NTNU-IES-education/teknobil/README.md

# Teknostart - elektronisk systemdesign og innovasjon

Velkommen til Elsys! For å varme dere opp til studiene har vi laget et lite intro-prosjekt til dere. Under prosjektet skal dere bygge og kjøre deres egen fjernstyrte bil. Underveis får dere prøve dere på Raspberry Pi og Arduino. Kanskje dette er kjent for noen av dere, og helt nytt for andre. Det er helt greit. Vi forventer bare at dere er nysgjerrig og gira for å komme i gang:) Lykke til!

Det vanker også premie for den vakreste/kuleste bilen, så bruk kreativiteten, maling og tusjer til å skreddersy bilen slik dere ønsker.

Del dere opp og jobb parallelt på de ulike delene. Dere har god tid, så bruk den gjerne på å utforske og prøve dere fram. Vi foreslår at dere fordeler dere på disse hovedoppgavene:

1.	[Raspberry Pi](#sette-opp-sd-kortet): Her er det viktig å holde tungen rett i munnen og følge instruksjonene nøye.  
2.	[Arduino](#Arduino)
3.  Steg 1 - 5

Til slutt kan dere samarbeide om å koble alt sammen og få bilen til å fungere. Når bilen fungerer kan dere gå videre med utvidelsesoppgavene og/eller skreddersy estetikken slik dere ønsker.

Står dere fast? Spør studassene om hjelp! Vi er her for å hjelpe dere, og kanskje føle oss litt smarte underveis:)

## Innholdsfortegnelse
- [Introduksjon til komponentene](#introduksjon-til-komponentene)
- [Trinnvisveiledning for montering av Teknobilen](#Trinnvis-veiledning-for-montering-av-Teknobilen)
  - [Montering av Teknobilen](#Montering-av-Teknobilen)
  - [Arduino](#arduino)
  - [Raspberry Pi Oppsett](#raspberry-pi-oppsett)
- [Utvidelser](#utvidelser)
  - [Hastighet](#hastighet)
  - [led](#led)
  - [Tutehorn](#tutehorn)
  - [Lobe](#lobe)
****

# Introduksjon til komponentene

Settet dere har fått utdelt inneholder komponenter som sikkert er nye for mange av dere. Her er en liten gjennomgang som forklarer hva de gjør. Det er ikke nødvendig å lese denne delen så nøye, men dere kan se over for å forstå hvilke komponenter vi omtaler i instruksjonene.

## Breadboard

Et breadboard gir en rask måte å koble opp kretser for prototyping uten å måtte lodde eller lage kabler. Hver rad i breadboardet er koblet til samme spenning.

<p align="center">
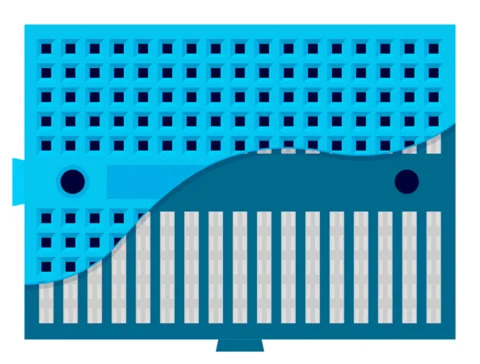
[picture p1: Media/teknobil/Breadboard.jpg]
  
</p>

## Spenningsregulator

Komponenten på bildet under er en spenningsregulator. Denne er viktig fordi Arduino og Raspberry Pi tåler ikke høyere spenning enn 5 V, men batterispenningen er på over 7.2 V. Denne har da til formål å senke spenningen slik at både Arduino og Raspberry Pi kan drives fra samme kilde. [Her](https://wiki.dfrobot.com/Power_Module__SKU_DFR0205_) er lenke til dokumentasjon.

<p align="center">
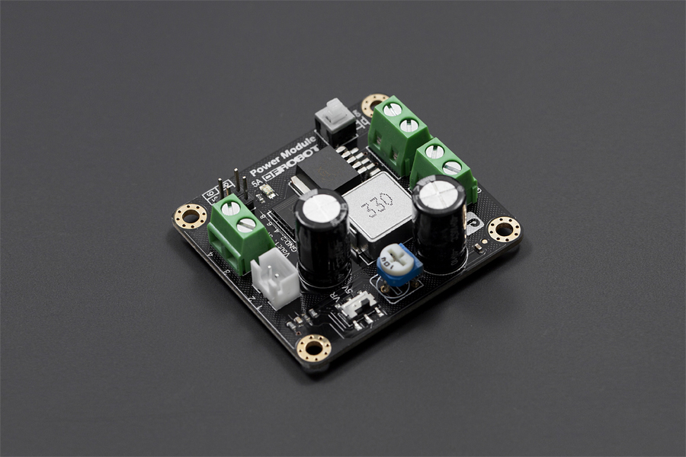
[picture p2: Media/teknobil/Powermodule.jpg]
  
</p>

## Arduino Uno

Arduino Uno er et lite utviklingskort som egner seg godt for nybegynnere. For å programmere denne brukes Arduino IDE med språket C++, supplert av Arduinos egne biblioteker og funksjoner. [Her](https://store.arduino.cc/pages/uno-r4) finner dere mer spesifikasjoner om kortet dere har blitt utdelt.

<p align="center">
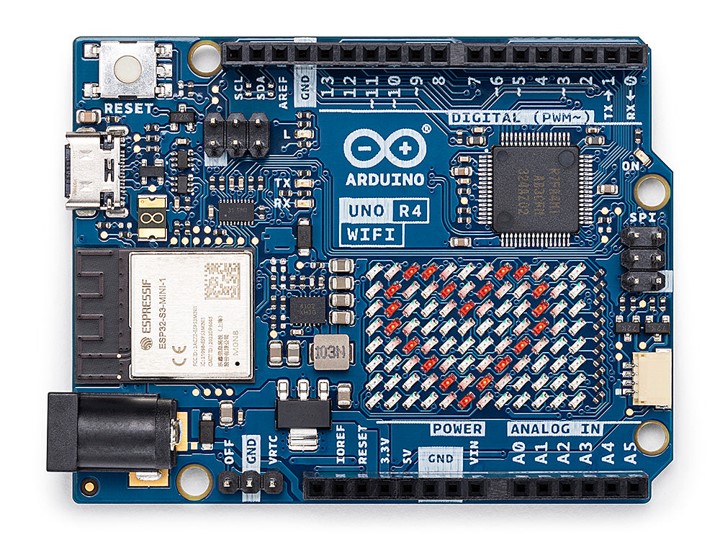
[picture p3: Media/teknobil/ArduinoUno.jpg]
  
</p>

## Motordriver

Motordriveren som dere har fått utdelt er et såkalt shield for Arduino Uno. Den kan plasseres rett på Arduino Uno, uten noen ekstra ledninger mellom de to. Denne må i tillegg kobles til motorspenning og til motorene den skal kontrollere. [Her](https://wiki.dfrobot.com/Quad_Motor_Driver_Shield_for_Arduino_SKU_DRI0039) finner dere ekstra dokumentasjon.

<p align="center">
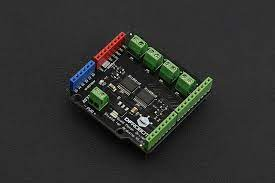
[picture p4: Media/teknobil/Motordriver.jpg]
  
</p>

## Raspberry Pi

Raspberry Pi er en liten datamaskin på størrelse med et kredittkort. Den klarer alt som forventes av en PC fra websurfing til dataspill. **PS! Det er low supply. Don't destroy plis😭** I dette prosjektet brukes modellen Raspberry Pi 3 Model B+. [Her](https://www.raspberrypi.com/documentation/) finner dere mer dokumentasjon om Raspberry Pi.

<p align="center">
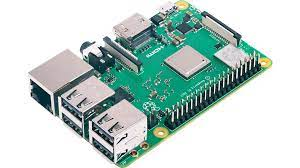
[picture p5: Media/teknobil/RaspberryPi3.jpg]
  
</p>

# Trinnvis veiledning for montering av Teknobilen
Før dere starter monteringen, er det greit å ha en oversikt over hvordan Teknobilen fungerer.

Raspberry Pi er systemets hjerne og kjører en nettside som lar dere styre bilen. Arduino tar seg av motorstyringen. De to kortene kommuniserer via GPIO-pinner, der Raspberry Pi sender kommandoer som Arduino bruker til å kontrollere motorene.

La oss montere! 

## Montering av Teknobilen

Følg trinnene nedenfor nøye for å montere Teknobilen. Alle bilder nevnt i veiledningen kan finnes i mappen [Media/teknobil](https://github.com/PeterhdPham/teknobil2023/tree/main/Media/teknobil).

### Steg 1: Montering av motorer

Start med å feste motorene til følgende plater med de 25 mm lange M3 skruene. Ledningene på motorene skal tres gjennom de store firkantede hullene. 
(NB! Ettersom dere ikke benytter muttere vær oppmerksom på ikke å stramme skruene for hardt).

<p align="center">
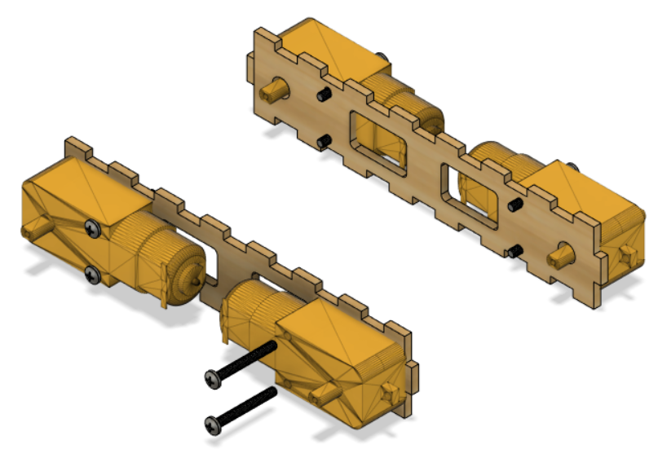
[picture p6: Media/teknobil/01.png]
  
</p>

### Steg 2: Sammensetting av baseplate og avlange plater

Fest så de avlange platene sammen med baseplaten (den store med hull). Pass på at baseplaten er riktig vei som vist på bildet slik at hullene passer med komponentene som skal skrus på senere.

<p align="center">
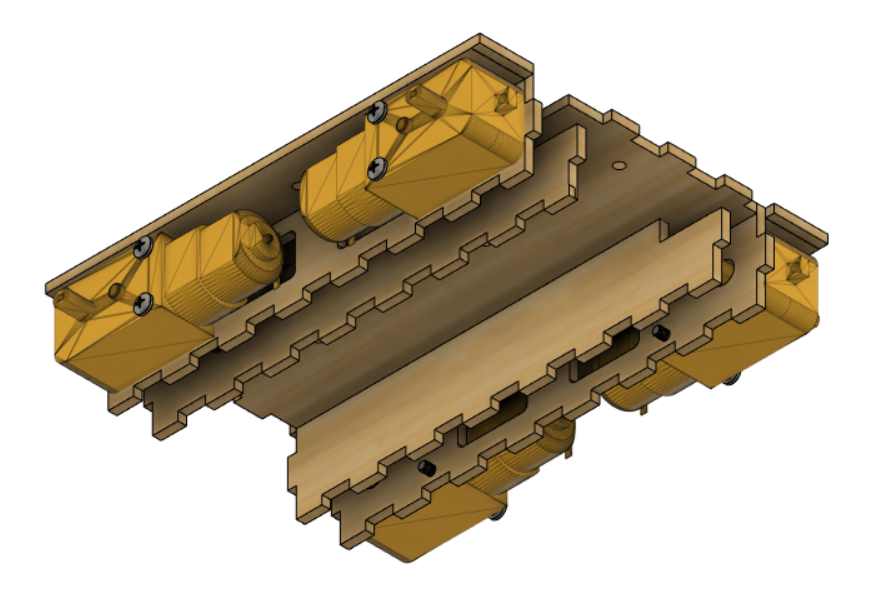
[picture p7: Media/teknobil/02.png]
  
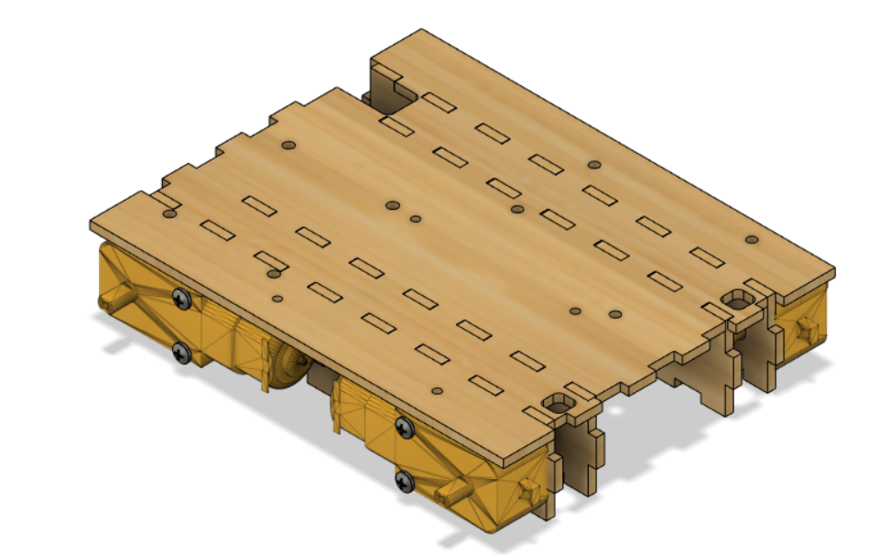
[picture p8: Media/teknobil/03.png]
  
</p>

### Steg 3: Ledninger

Nå kan det være lurt å føre ledningene fra motorene igjennom de to firkantede hullene i baseplaten.

<p align="center">
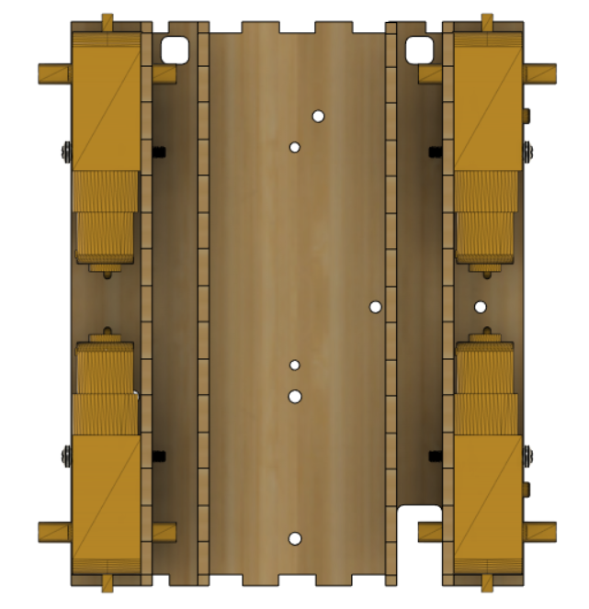
[picture p9: Media/teknobil/04.png]
  
</p>

### Steg 4: Montering av bunnplate

Fest bunnplaten.

<p align="center">
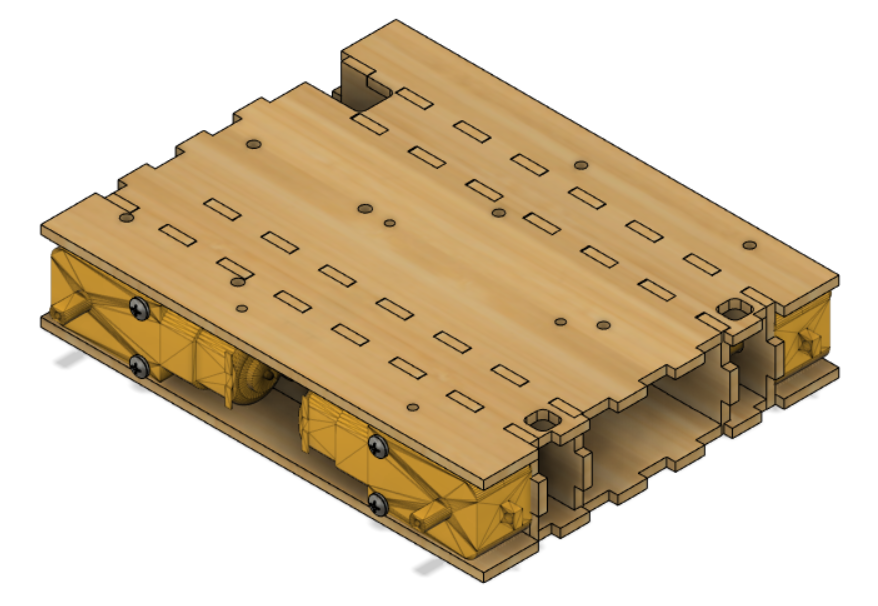
[picture p10: Media/teknobil/06.png]
  
</p>

### Steg 5: Raspbian

Før dere fortsetter med å feste komponentene bør oppsettet av Raspberry Pi være ferdig, ettersom dere ikke vil få tilgang til SD-kortet etter at alt er skrudd på plass. Dere bør ha fullført dette steget [her](#sette-opp-sd-kortet).

### Steg 6: Montering av komponenter

Legg komponentene som vist på bildet og skru dem fast inn i baseplaten med de 10 mm lange M2.5 skruene.

<p align="center">
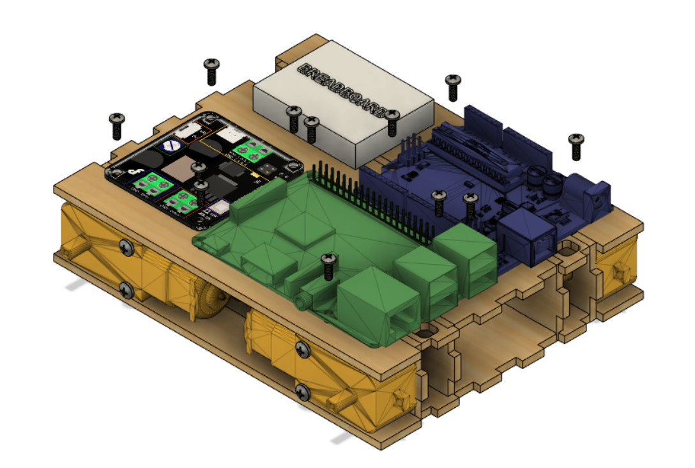
[picture p11: Media/teknobil/08.png]
  
</p>

### Steg 7: Montering av frontplate og kamera

Fest frontplaten og skru fast kameraet til platen med de 4 mm lange M2 skruene som vist på bildet under.

<p align="center">
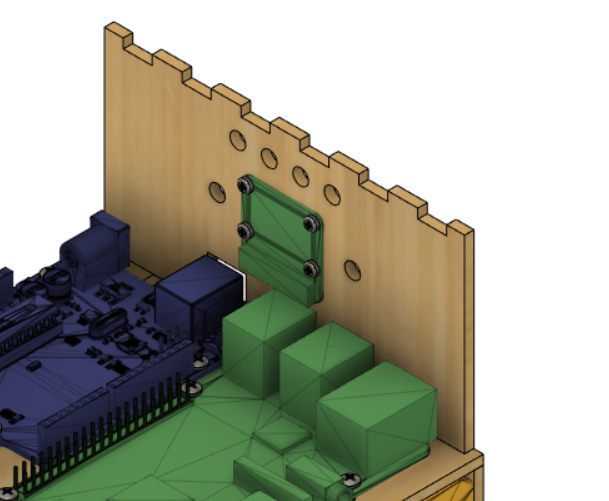
[picture p12: Media/teknobil/09.png]
  
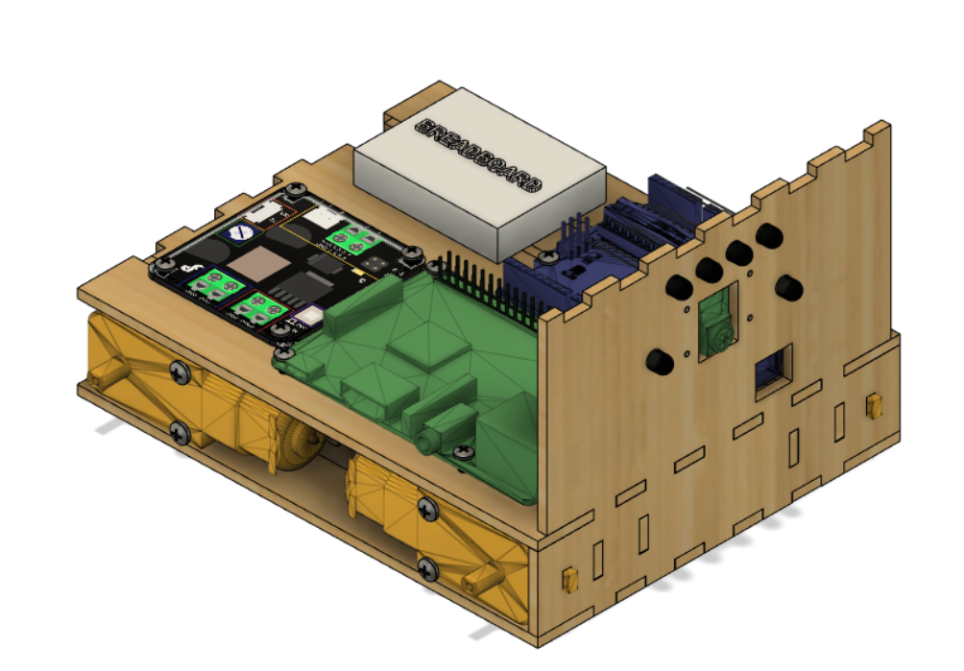
[picture p13: Media/teknobil/10.png]
  
</p>

Koble kamera til Raspberry Pi med den flate kamerakabelen som vist på bildet under. Sørg for å sette den inn riktig vei.

<p align="center">
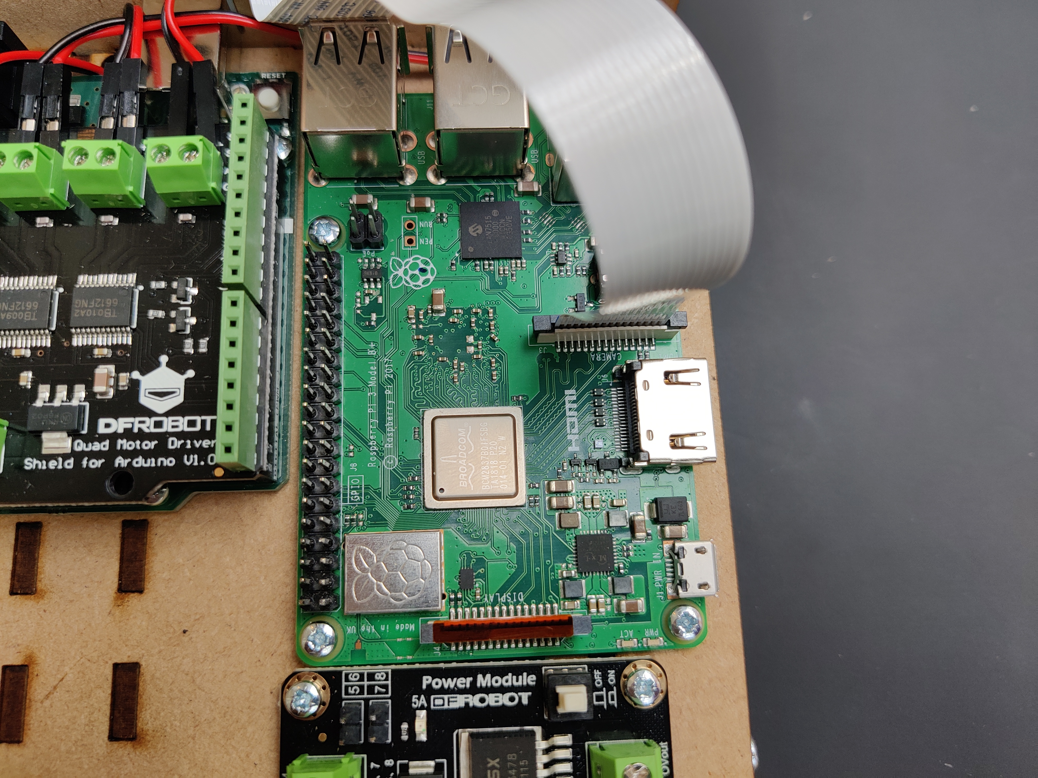
[picture p14: Media/teknobil/15.jpg]
  
</p>

### Steg 8: Oppkobling av spenningskilde og motor

Dere har nå kommet til et kritisk punkt i prosjektet - det er tid for å koble sammen komponentene. Det er avgjørende at dere følger koblingsskjemaene nøye. Ta en god titt på figurene og sørg for at dere har koblet riktig pins mellom spenningsregulatoren og Raspberry Pi samt Arduino.

Under ser dere pinout for Arduino, strømmodulen og Raspberry Pi.

Husk, nøyaktighet er nøkkelen her, så vær tålmodig og dobbeltsjekk alle tilkoblinger før dere fortsetter. I Illustrasjonen under så kobles 

<p align="center">
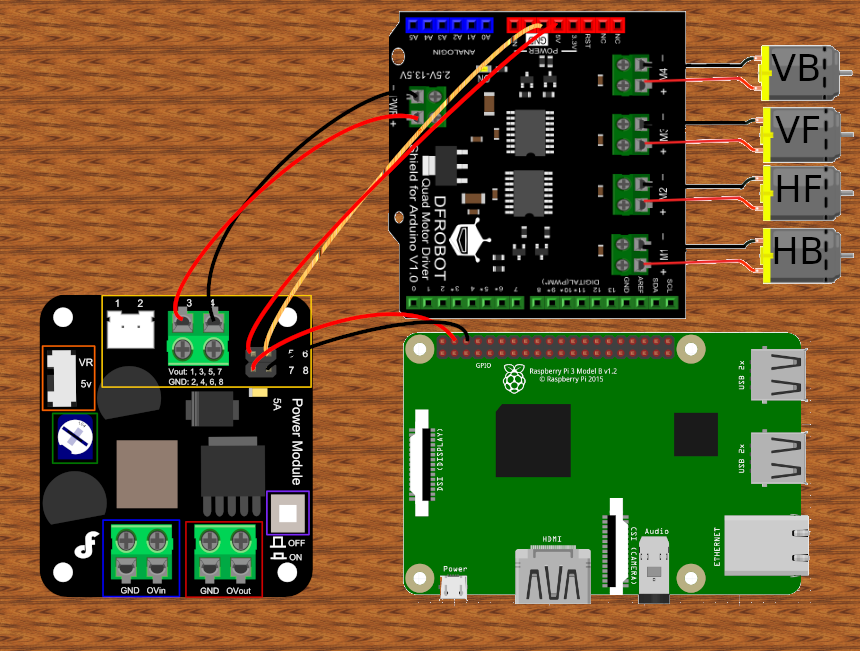
[picture p15: Media/teknobil/oppkoblingPSU.png]
  
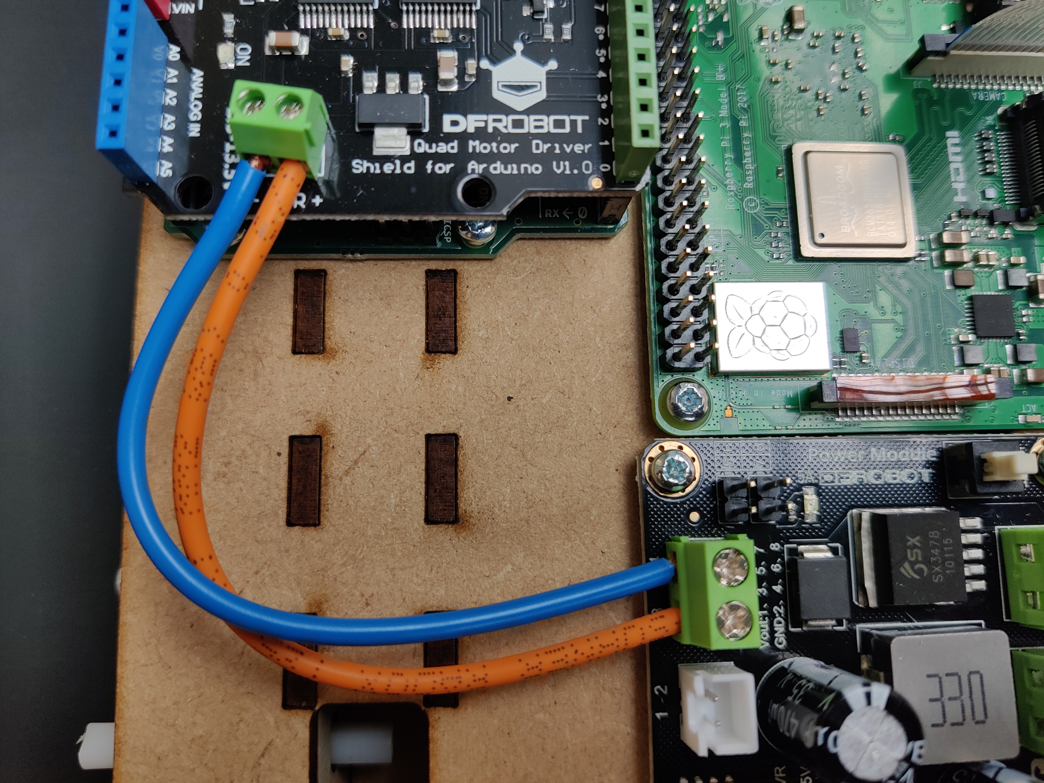
[picture p16: Media/teknobil/16.jpg]
  
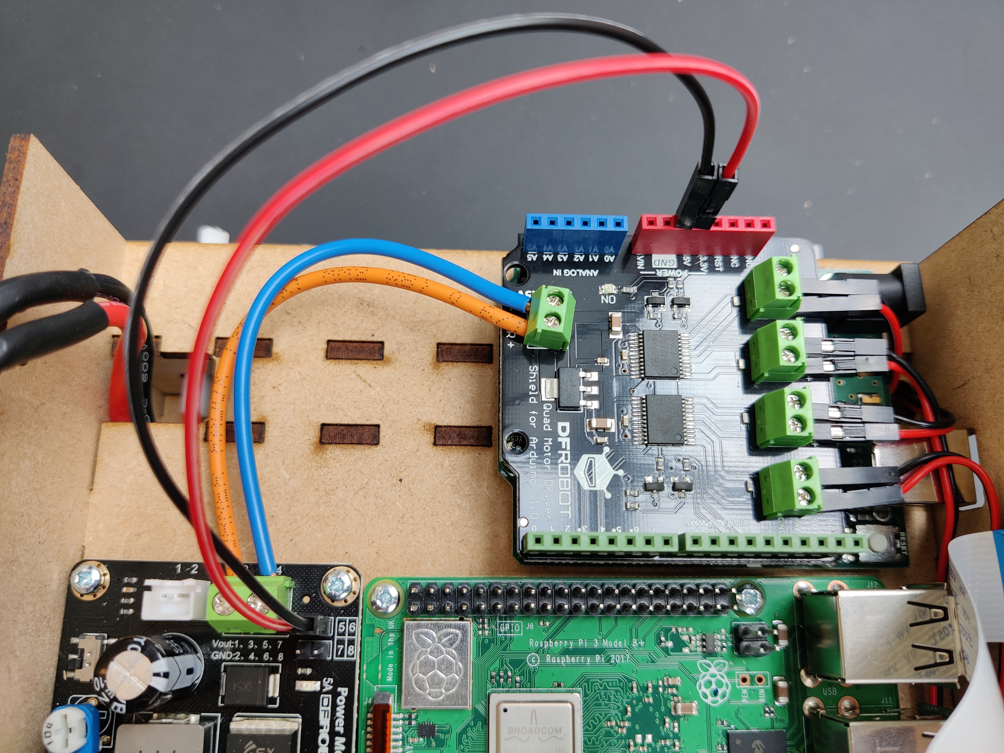
[picture p17: Media/teknobil/17.jpg]
  
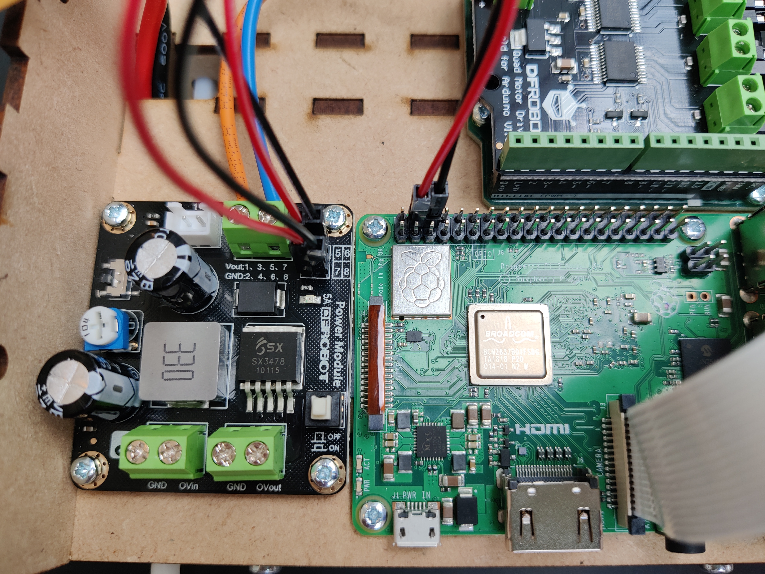
[picture p18: Media/teknobil/18.jpg]
  
</p>

som vist i illustrasjonen så kobles motorene og komponentene  slikt:

<table>
<tr><td>

| Motorshield | Motor |
|---|---|
| M1 | HØYRE BAK |
| M2 | HØYRE FRONT  |
| M3 | VENSTRE FRONT|
| M4 | VENSTRE BAK  |

</td><td>&nbsp;&nbsp;&nbsp;&nbsp;&nbsp;</td><td>

| Power Module | Arduino/RPI/Motor |
|---|--- |
| 3 (V_out) | Motor (+) |
| 4 (GND) | Motor (-) |
| 5 (V_out) | Arduino (5V) |
| 6 (GND) | Arduino (GND) |
| 7 (V_out) | RPI (5V PWR) |
| 8 (GND) | RPI (GND) |

</td></tr> </table>

### Steg 9: Oppkobling av GPIO

For å koble sammen Raspberry Pi og Arduino Uno, må dere merke deg at nummeret på GPIO-pinnen ikke er det samme som nummeret langs pinneraden på kortet som beskriver hvor pinnen er plassert. GPIO pinout for Raspberry Pi og tabell for tilkobling med Arduino er vist under. Bruk dette for å koble sammen de to kortene.

<p align="center">
  
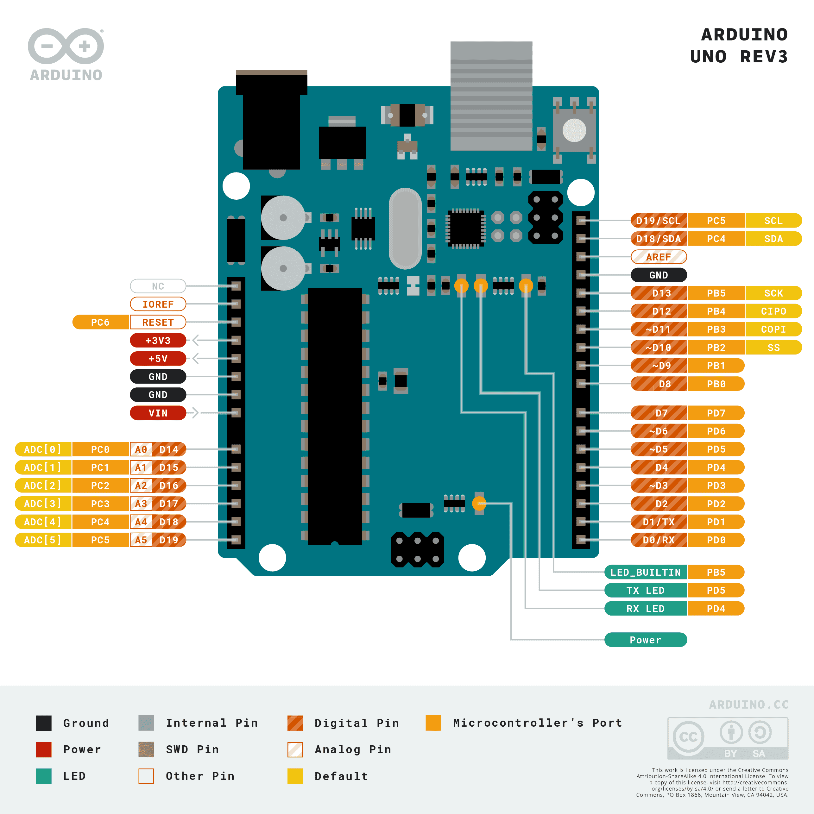
[picture p20: Media/teknobil/Arduino_pinout.png]
  
<table>
    <tr>
        <td>
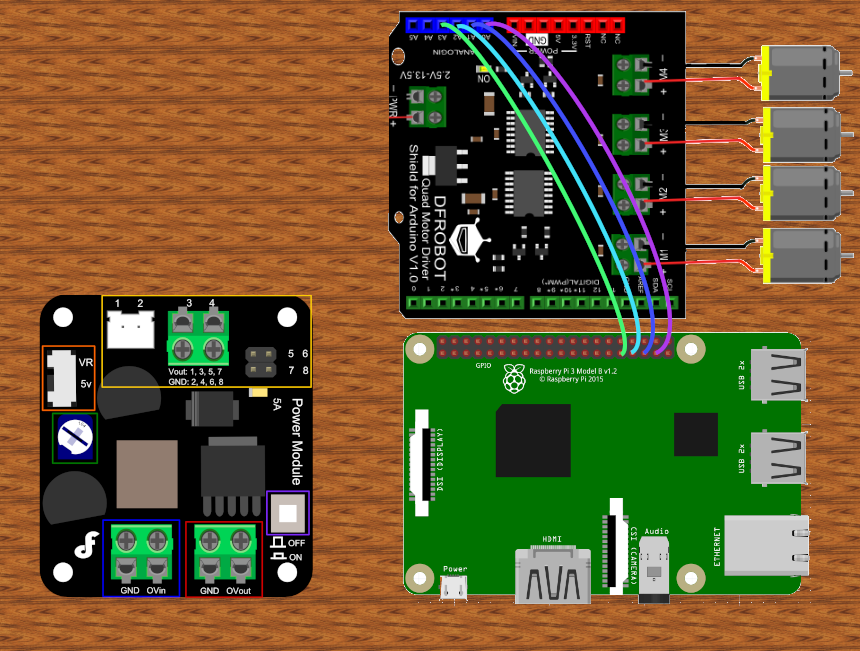
[picture p21: Media/teknobil/oppkoblingRPIArduino.png]
            
        </td>
        <td>
          
| Arduino | Raspberry Pi |
|---|---|
| A3 | GPIO 6 |
| A2 | GPIO 13 |
| A1 | GPIO 19 |
| A0 | GPIO 26 |

</table>

Hvis dere har koblet riktig, skal det se ut som vist under.

<p align="center">
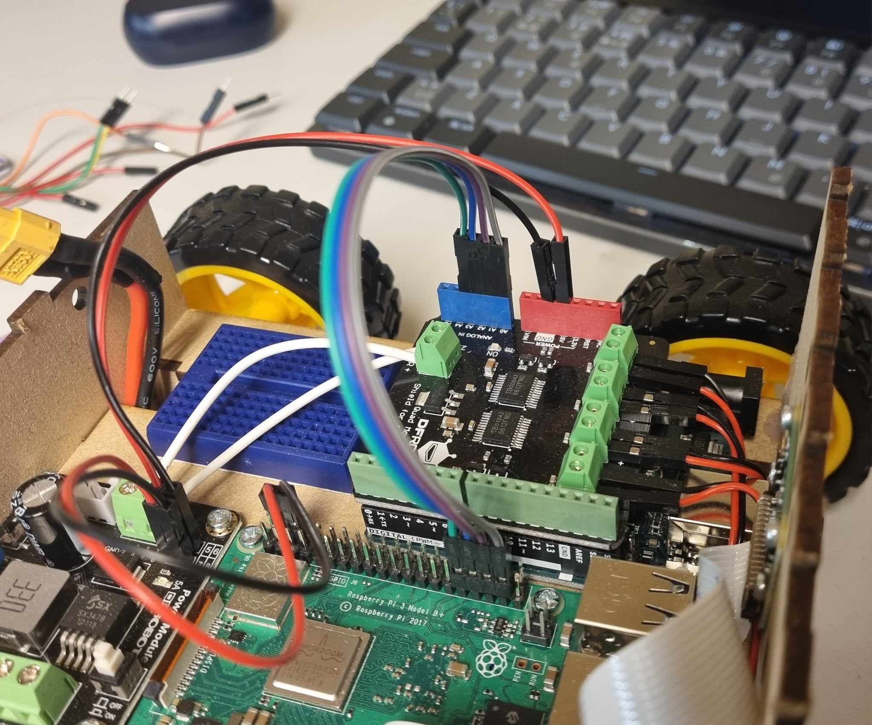
[picture p22: Media/teknobil/19.jpg]
  
</p>

### Steg 10: Oppkobling av lysdioder (LEDs)

Hver LED har to ben; en kort (katode) og en lang (anode), dette tilsvarer LED-ens positive og negative side som vist i illustrasjonen under.

1.  **Koble motstandene til brødfjølet**: Koble en 220-ohms motstand til brødfjølet. Dere vil trenge en for katodene til kjøre-LED og rygge-LED (2 røde og 2 gjennomsiktige), og en annen for de andre LEDene (rødt, gult, grønt, blått).

2.  **Koble til GND**: Koble Raspberry Pi's GND (jord) pinne til brødfjølet, deretter til motstanden(e).

3. **Koble til GPIO-pinnene**: Bruk jumperkabler til å koble anoden (den lengre delen av LED) direkte til de tilsvarende GPIO-pinnene på Raspberry Pi. Katodene (den kortere delen av LED) kobles til brødfjølet (som er koblet til GND gjennom motstanden) ved hjelp av jumperkabler.

Her er den tilsvarende tilkoblingen:

<table align="left" border="0">
    <tr>
        <th>GPIO-tilkoblinger</th>
        <th>Funksjon</th>
    </tr>
    <tr>
        <td>20</td>
        <td>kjøreled (Gjennomsiktig LED)</td>
    </tr>
    <tr>
        <td>21</td>
        <td>kjøreled (Gjennomsiktig LED)</td>
    </tr>
    <tr>
        <td>2</td>
        <td>Ryggeled (Rødt LED)</td>
    </tr>
    <tr>
        <td>3</td>
        <td>Ryggeled (Rødt LED)</td>
    </tr>
    <tr>
        <td>1</td>
        <td>Rødt led</td>
    </tr>
    <tr>
        <td>7</td>
        <td>Gult led</td>
    </tr>
    <tr>
        <td>8</td>
        <td>Grønt led</td>
    </tr>
    <tr>
        <td>25</td>
        <td>Blått led</td>
    </tr>
</table>

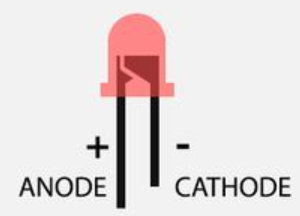
[picture p23: Media/teknobil/LED.png]

<br clear="all" />

**Viktig:** En motstand er nødvendig for å begrense strømmen som går gjennom LEDene, og dermed hindre dem i å brenne ut. Alltid koble motstanden til katodesiden (den kortere benet) av LEDen.

<p align="center">
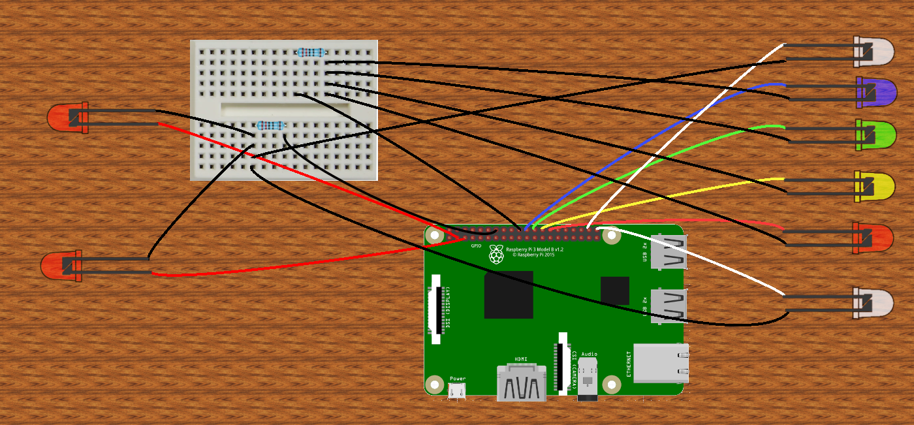
[picture p24: Media/teknobil/oppkoblingLED.png]
  
</p>

Illustrasjonen over viser et forslag til hvordan en ferdig krets kan se ut. Bildet under viser hvor kaotisk det kan bli etter at det er ferdig. Lykke til 😈

<p align="center">
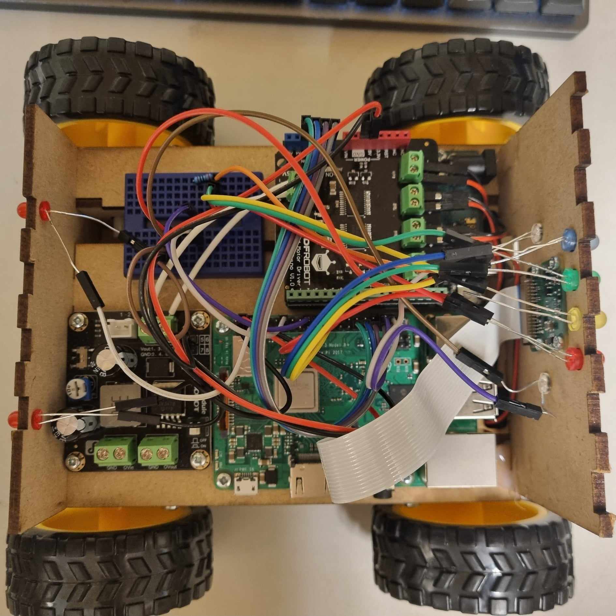
[picture p25: Media/teknobil/realLED.jpg]
  
</p>

### Steg 11: Kontroll og kobling av batteri

Batterikontaktoren til spenningsregulatoren kobles opp som vist under. Pass på at den positive (røde) ledningen er koblet til OV_in og den negative (svarte) ledningen er koblet til GND.

<p align="center">
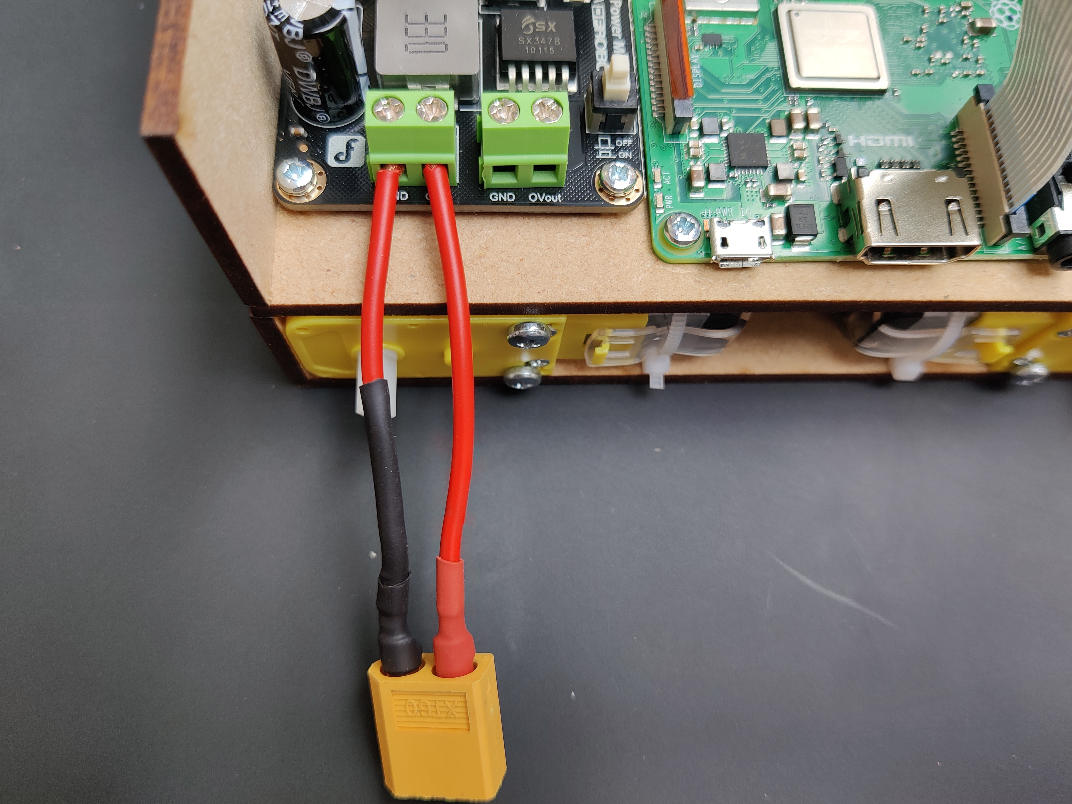
[picture p26: Media/teknobil/20.jpg]
  
</p>

Når alt er koblet opp, kan dere få bilen deres kontrollert av en studass. Hvis alt er korrekt, kan dere få utlevert et batteri som skal skyves inn mellom motorene før dere fester bakplaten.

**NB: Her er det tre viktige ting å være oppmerksom på.** 
- **Pass på at skruene som holder kretskortene på plass ikke er skrudd så stramt at batteriet tar skade når det skyves inn i bilen. Det er også viktig å være forsiktig så man ikke skrur dem inn i batteriet senere, ellers kan batteriet begynne å brenne.**
- **Sørg for at bryteren er satt til 5 V på spenningsregulatoren før dere skrur den på.**
- **Ikke la batteriet være koblet opp i løpet av natten**

<p align="center">
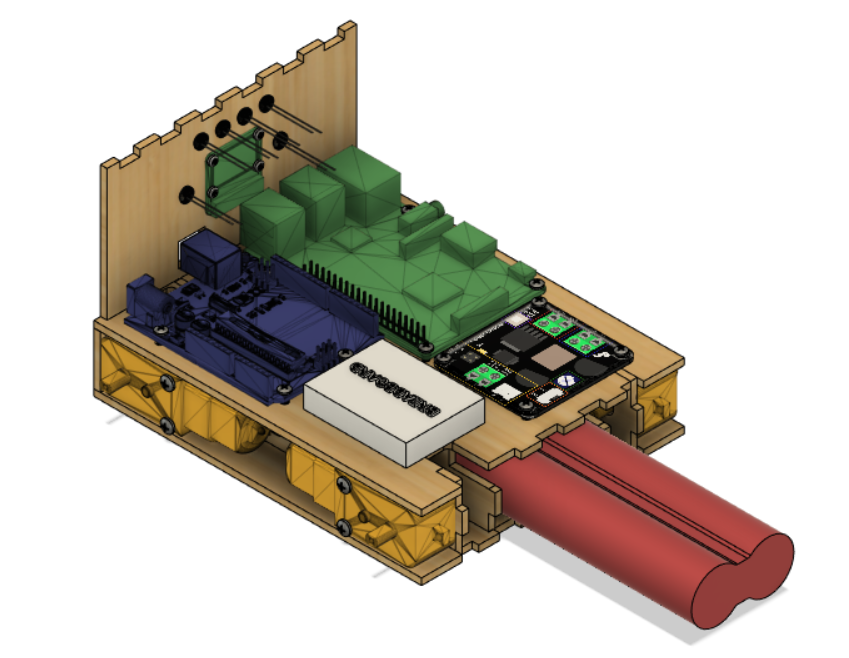
[picture p27: Media/teknobil/11.png]
  
</p>

<p align="center">
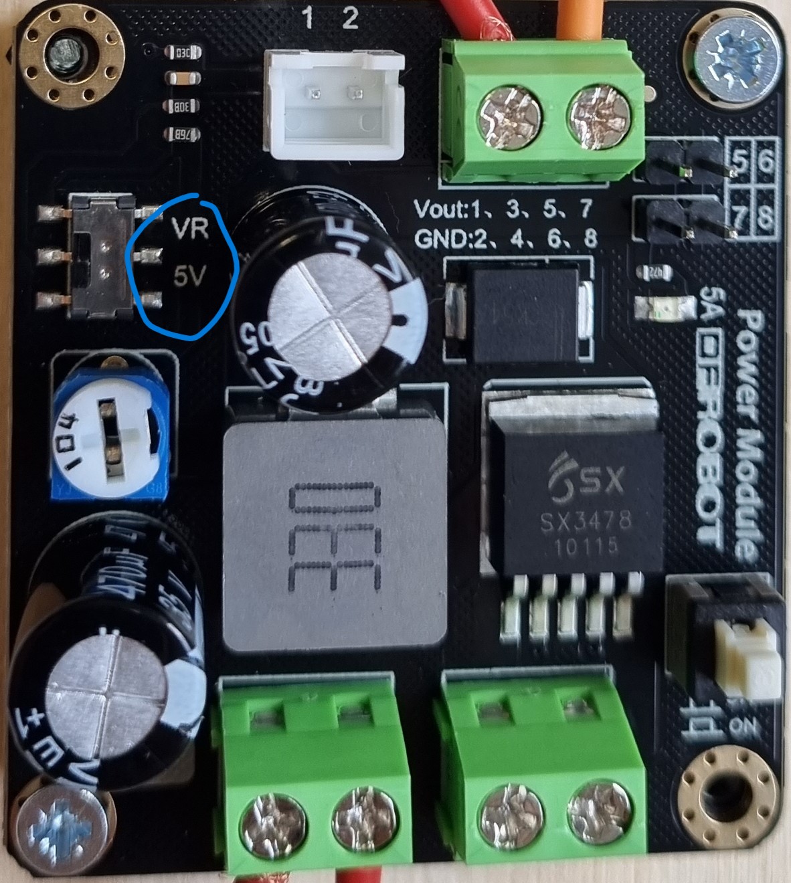
[picture p28: Media/teknobil/22.jpg]
  
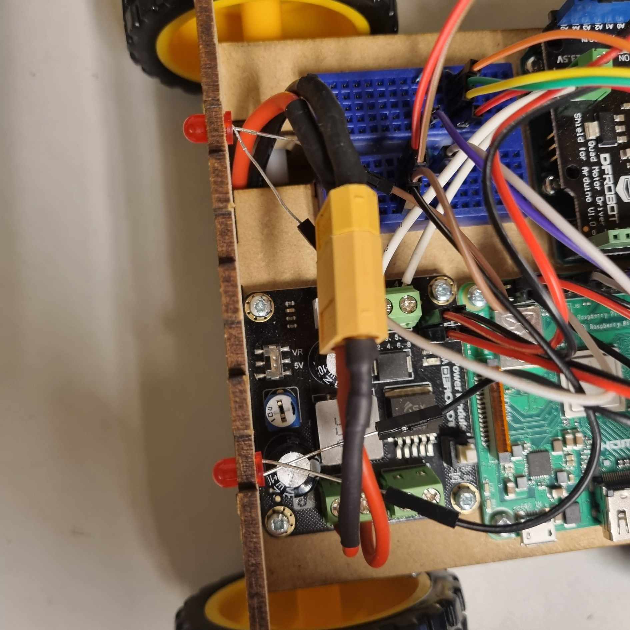
[picture p29: Media/teknobil/batteri_connection.jpg]
  
</p>

### Steg 12: Montering av bakplate og topplokk

Fest bakplaten og sett på toppdekslet. Bilen skal nå se ut som vist under.

<p align="center">
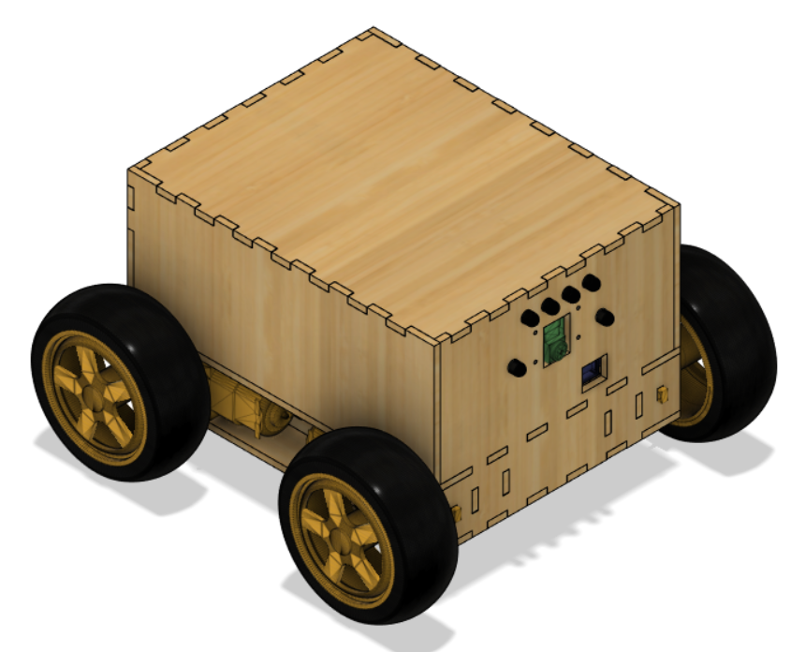
[picture p30: Media/teknobil/14.png]
  
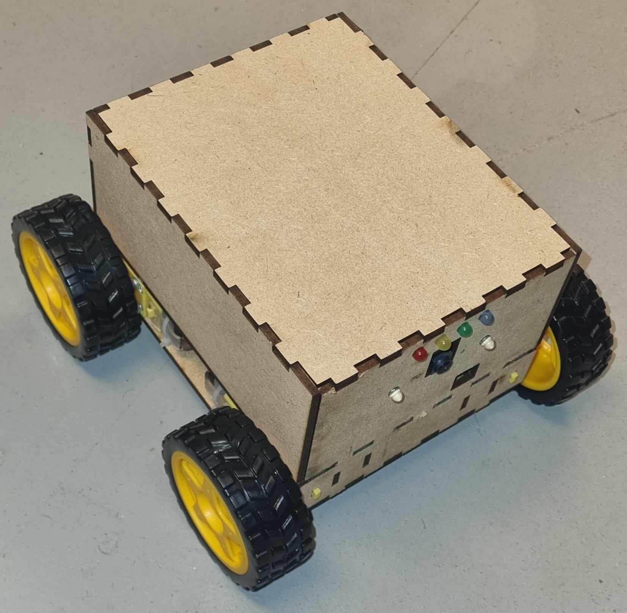
[picture p31: Media/teknobil/last.jpg]
  

</p>

## Arduino
Arduino er en open-source elektronikkplattform med brukervennlig hardware og software. Kortene kan lese ulike inngangssignaler som et knappetrykk og bruke disse til å sende utgangssignaler som å aktivere en motor. Dere programmerer kortet ved å skrive instruksjoner i Arduino IDE og laste dem opp via USB.

### Skaff Arduino Software til egen PC

Last ned Arduino IDE
* [Guide på hvordan å laste ned for Windows, Mac, og Linux](https://docs.arduino.cc/software/ide-v2/tutorials/getting-started/ide-v2-downloading-and-installing/)

### Last inn koden til Arduinoen
Utstyr:
1. PC
2. USB-A til USB-C-kabel
3. Arduino Uno

Oppsett:
1. Koble Arduino-kortet til PCen din med en USB-C kabel
2. Sørg for at programvaren er satt opp for riktig type Arduino-kort, i dette tilfellet Arduino Uno R4 Wifi
    * Gå inn på «Verktøy» eller «Tools»
    * Velg riktig kort og port (porten refererer til hvilken inngang/utgang dere bruker på PCen. Det kan oppstå en feilmelding hvis feil port er valgt)

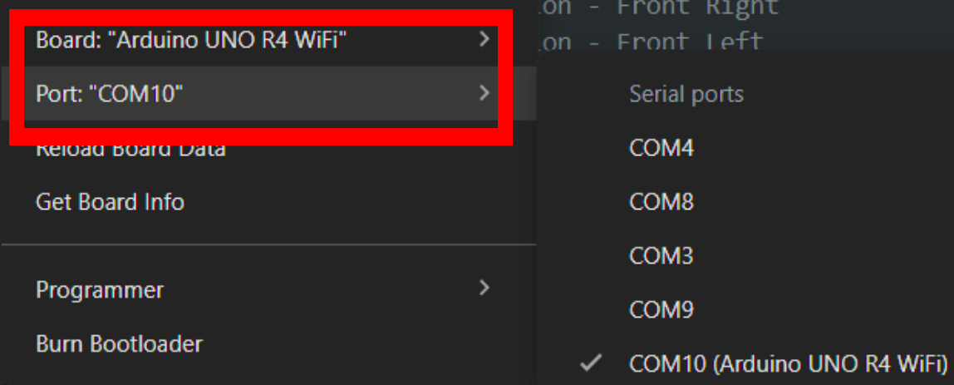
[picture p32: Media/arduino/01toolssetup.png]
Arduino


Hvis dere ikke kan velge riktig kort, så må dere laste ned en liten pakke. Naviger til "Boards Manager" (ikonet på venstre side meny som vist i bilde), søk opp "Arduino Uno R4", og trykk install "Arduino UNO R4 Boards".

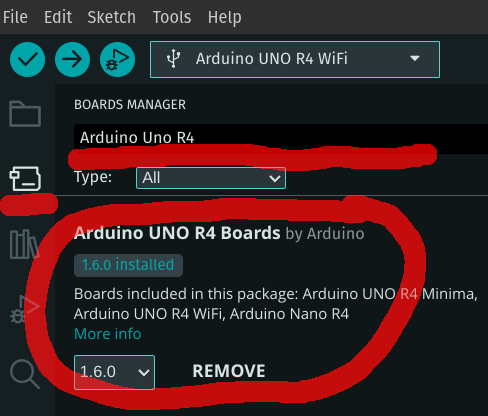
[picture p33: Media/arduino/01.5BoardManager.png]
Arduino Boards


3. Erstatt deretter den eksisterende teksten med koden under:

    <details>
    <summary>Klikk her</summary>

    ```c
    
    //MOTOR SETUP
    const int E1 = 3; ///<Motor1 Speed - Back Right
    const int E2 = 11;///<Motor2 Speed - Front Right
    const int E3 = 5; ///<Motor3 Speed - Front Left
    const int E4 = 6; ///<Motor4 Speed - Back Left

    const int M1 = 4; ///<Motor1 Direction - Back Right
    const int M2 = 12;///<Motor2 Direction - Front Right
    const int M3 = 8; ///<Motor3 Direction - Front Left
    const int M4 = 7; ///<Motor4 Direction - Back Left

    /////////LOGIC/////////////////////////////////
    //INPUT PINS
    int drive = A0;
    int reverse = A1;
    int leftTurn = A2;
    int rightTurn = A3;

    //BOOLS
    int go = 0;
    int back = 0;
    int left = 0;
    int right = 0;

    //SPEEDS
    int drivingSpeed = 150;
    int turningSpeed = 50;

    enum Motor {
      MotorRight,
      MotorLeft,
      MotorBoth
    };

    //////DRIVING FUNCTIONS//////////////////////
    void speedSet(Motor motor, int Speed) {
        if(motor == MotorLeft){
            analogWrite(E1, Speed);
            analogWrite(E2, Speed);
        }
        else if(motor == MotorRight){
            analogWrite(E3, Speed);
            analogWrite(E4, Speed);
        }
        else if(motor == MotorBoth){
            analogWrite(E1, Speed);
            analogWrite(E2, Speed);
            analogWrite(E3, Speed);
            analogWrite(E4, Speed);
        }
    }

    //DRIVING FUNCTION
    void driving(Motor motor, bool Direction) {
        if (motor == MotorBoth){
            digitalWrite(M1, !Direction);  // Invert the direction for rear wheels
            digitalWrite(M2, Direction);
            digitalWrite(M3, Direction);
            digitalWrite(M4, !Direction);  // Invert the direction for rear wheels
        }
        else if (motor == MotorRight){
            digitalWrite(M1, !Direction);  // Invert the direction for rear right wheel
            digitalWrite(M2, Direction);
        }
        else if (motor == MotorLeft){
            digitalWrite(M3, Direction);
            digitalWrite(M4, !Direction);  // Invert the direction for rear left wheel
        }
    }

    ////SETUP///////////////////////
    void setup() {
      Serial.begin(9600);   
      Serial.println("Starting session...");

      //SET PINS 
      pinMode(drive, INPUT_PULLUP);
      pinMode(reverse, INPUT_PULLUP);
      pinMode(leftTurn, INPUT_PULLUP);
      pinMode(rightTurn, INPUT_PULLUP);

      for(int i=3;i<=8;i++) {
          pinMode(i,OUTPUT);
          digitalWrite(i, LOW);  // Initiate as LOW
      }

      for(int i=11;i<=13;i++) {
          pinMode(i,OUTPUT);
          digitalWrite(i, LOW);  // Initiate as LOW
      }
    }

    void loop() {
    //UPDATING THE BOOLEANS
    go = digitalRead(drive);
    back = digitalRead(reverse);
    left = digitalRead(leftTurn);
    right = digitalRead(rightTurn);

    /////FORWARD DRIVE/////////////////////////////////////////
      if (go && !back) {
        driving(MotorBoth, 0);
        if (right) {
            speedSet(MotorLeft, turningSpeed);   // Adjust to turn right
            speedSet(MotorRight, drivingSpeed);  // Maintain driving speed
        } else if (left) {
            speedSet(MotorRight, turningSpeed);  // Adjust to turn left
            speedSet(MotorLeft, drivingSpeed);   // Maintain driving speed
        } else {
            speedSet(MotorBoth, drivingSpeed);
        }
      }

        //REVERSE
      else if (back && !go) {
        driving(MotorBoth, 1);
        if (right) {
            speedSet(MotorLeft, turningSpeed);   // Adjust to turn right in reverse
            speedSet(MotorRight, drivingSpeed);  // Maintain driving speed in reverse
        } else if (left) {
            speedSet(MotorRight, turningSpeed);  // Adjust to turn left in reverse
            speedSet(MotorLeft, drivingSpeed);   // Maintain driving speed in reverse
        } else {
            speedSet(MotorBoth, drivingSpeed);
        }
      }

    //RIGHTTURN
    else if(right && !go && !back){
        speedSet(MotorBoth, turningSpeed);
        if(!left){
            digitalWrite(M1, 0);  // Rear right wheel for right turn
            digitalWrite(M3, 0);  // Adjust front left wheel for right turn
            digitalWrite(M2, 1);  // Adjust front right wheel for right turn
            digitalWrite(M4, 1);  // Rear left wheel for right turn
            Serial.println("RIGHTTURN");
        }
        else{
            driving(MotorBoth, 0);
        }
    }

    //LEFTTURN
    else if(left && !go && !back){
        speedSet(MotorBoth, turningSpeed);
        if(!right){
            digitalWrite(M1, 1);  // Rear right wheel for left turn
            digitalWrite(M3, 1);  // Adjust front left wheel for left turn
            digitalWrite(M2, 0);  // Adjust front right wheel for left turn
            digitalWrite(M4, 0);  // Rear left wheel for left turn
            Serial.println("LEFTTURN");
        }
        else{
            driving(MotorBoth, 0);
        }
    }

        //IF YOU DON'T PRESS ANYTHING
        else{
            speedSet(MotorBoth, 0);
            Serial.println("STOP");
        }
    }

</details>

4. Last opp koden til Arduino-kortet. Klikk først på det blå ikonet for å verifisere koden (dobbeltkontroller at det ikke er noen feil med koden). Deretter klikker dere på det røde ikonet for å laste opp koden.
<p align='center'>
  <img src="Media/arduino/02yeah.png" width="240">
</p>
NB: Hvis motoren går i feil retning når dere tester den fullstendige oppkoblingen, er det sannsynligvis noe feil i oppkoblingen (enten feil motor koblet til feil port, eller feil på +/- ved inngangene på motordriveren). Dette kan dere prøve å rette på i Arduino-koden under «MOTOR SETUP», for å unngå å måtte gjøre omkoblinger, og for en liten ekstra utfordring. :)

## Raspberry Pi oppsett

I dette prosjektet bruker dere modellen Raspberry Pi 3B+. Den kjører en webserver som sender live-video fra et kamera, og lar dere styre bilen med piltastene i nettleseren. Tastetrykk sendes fra nettleseren til Pi-en, som videresender kommandoene til Arduino.

Som alle datamaskiner trenger Raspberry Pi et operativsystem (OS). På Raspberry Pi ligger OS-et på et SD-kort som også fungerer som harddisk, og som enkelt kan tas ut og settes inn igjen. Første steg er derfor å klargjøre dette SD-kortet.

### Sette opp SD-kortet

Utstyr:

- Laptop
- SD-kort
- SD-kortleser

SD-kortene dere har fått utdelt er tomme og må klargjøres før bruk. Raspberry Pi bruker ikke Windows eller macOS, men Raspberry Pi OS — et Linux-basert operativsystem bygget på Debian (tidligere kjent som Raspbian). For å skrive dette OS-et til SD-kortet brukes et verktøy som heter Raspberry Pi Imager.

Prosjektet krever en spesifikk versjon av både Raspberry Pi OS og Raspberry Pi Imager. Dette skyldes at prosjektets infrastruktur ble utviklet i 2023 og er tilpasset OS-versjonen som var tilgjengelig da. Dere må derfor laste ned versjonene som er beskrevet under.

Slik går dere frem for å sette opp SD-kortet:

1. Last ned Raspberry Pi Imager ([lenke](https://github.com/raspberrypi/rpi-imager/releases)).
    1. Bla til dere finner versjon 1.9.6
    2. Klikk på "Assets" (se rød firkant på bilde under)
    3. Velg den filen som tilsvarer ditt operativsystem (.exe for Windows, .dmg for Mac, anbefaler appImage for Linux)
   ![Raspberry Pi Imager Download](Media/rpi/00Pi-imager-download.png)
2. Last ned den versjonen av OS-et dere skal ha ([lenke](https://downloads.raspberrypi.com/raspios_oldstable_armhf/images/raspios_oldstable_armhf-2025-05-07/))
    1. Velg den filen som ender i .xz
    2. .xz er et fil format for komprimerte filer, akkurat som .zip filer. Så for å få bruk for filen, så må dere pakke den ut. Det burde være nok å høyre trykke og velge "Extract here", men hvis det ikke funker prøv å søke opp hvordan og se om dere klarer det selv, hvis ikke spør nærmeste studass om hjelp.
3. Sett SD-kortet inn i SD-kortleseren
4. Åpne Raspberry Pi Imager og trykk nei på å bruke nyere versjon
5. Klikk på "CHOOSE DEVICE" og velg "Raspberry Pi 3"
6. Klikk på "CHOOSE OS" og bla ned til dere kan velge "Use custom"
    1. Naviger til .img filen dere pakket ut i steg 2 og velg den
7. Deretter "CHOOSE STORAGE", og velg det SD-kortet dere satte inn. Menyen skal se omtrent slik ut etter dette:
   ![Raspberry Pi Imager](Media/rpi/01-Pi-imager-ny.png)
8. Trykk deretter på "NEXT" og det skal komme et "Use OS customization" sprettoppvindu. Velg så "EDIT SETTINGS" og sett opp følgende innstillinger:

   1. Sett hostname til «elsys"gruppenummer"», eksempel: elsys14
   2. Set username and password
      - Username: pi, NB: viktig at dere kun skriver “pi”
      - Password: "123", eller noe annet dere lett kan huske
   3. Configure wireless LAN
      - Dere bruker her en bestemt nettverksruter. SSID og Passord for nettverksruteren vil bli lagt ut på Canvas.
      - Alternativ dersom det ikke virker med nettverksruter: Delt nett fra mobilene deres. Vi anbefaler at man bruker en Android-telefon. SSID og Passord må være identisk med det nettverket dere deler fra den valgte mobilen. Det er også lurt at navnet til mobilen er skrevet i ett ord, som "KariPhone" istedenfor "Kari's iPhone". Og ikke bruk spesielle karakterer.
      - Skriv korrekt! Om ikke må man kanskje sette opp alt på nytt igjen.
   4. Enable Set locale settings:
      - Time zone: Europe/Oslo
      - Keyboard layout: NO
   5. Aktiver SSH under "SERVICES"-fanen
      - Velg "Use password authentication"
   5. Når dere er ferdig skal dere se noe tilsvarende:

   ![Raspberry Pi Imager settings](Media/rpi/02settings.png) | ![Raspberry Pi Imager settings](Media/rpi/02settingssh.png)

9. Lagre innstillingene med "SAVE", og trykk på "YES" i sprettoppvinduet fra tidligere og deretter "YES" i den påfølgende advarselen. Deretter begynner skrivingen, som kan ta litt tid.
10. Når SD-kortet er ferdig skrevet vil dere få en beskjed om at det er trygt å ta det ut av maskinen. Ta det ut, og sett inn i Pi-en.

### Sette opp Raspberry Pi headless
Raspberry Pi kan brukes uten skjerm eller tastatur — dette kalles headless-oppsett. For å koble til Pi-en fra PC-en brukes Secure Shell Protocol (SSH), som dere aktiverte tidligere i Raspberry Pi Imager-innstillingene.

SSH krever at begge enhetene er på samme nettverk. Koble PC-en til nettverksruteren som er satt opp for dette prosjektet. Merk at dette nettverket kun skal brukes av den som jobber med Raspberry Pi — for mange tilkoblinger kan overbelaste det. Bruker dere delt nett fra mobil gjelder det samme: PC-en må kobles til det samme delte nettverket.

Utstyr:
- PC
- Raspberry Pi med ferdig installert SD-kort
- Nettverksruter eller Delt nett fra mobil

#### SSH inn til Raspberry Pi

1. Først må Pi-en være koblet til strøm. Dette gjøres enten ved oppkobling i bilen eller ved mikro-USB-porten på kortet.
2. Åpne en terminal på laptopen:
   - For Windows kan dere søke opp:
     - Terminal (win + x)
     - Windows PowerShell
     - Command Prompt
   - For Mac kan dere søke opp:
     - Terminal
3. For å SSH inn til Pi-en går dere inn på terminalen og skriver:
  ```bash
  ssh pi@<hostname>.local
  ```
bytt ut <hostname> med det dere satte i Raspberry Pi imager F.eks:
   ```bash 
   ssh pi@elsys1.local 
   ```

Når den spør om dere ønsker å koble til, skriv “yes” og trykk enter.

Om dere ikke får koblet til så se på feilsøkingstipsene nedenfor:
* Prøv å bruke IPv4-adressen til PI-en istedenfor ```<hostname>.local```. Den finner dere vanligvis i nettverksdelingsinnstillingene på mobilen og har på formatet ```<xxx.xxx.xxx.xxx>```, hvor x er tall. Kommandoen blir da f.eks. ```ssh pi@192.168.195.162```.
* Det kan ta litt tid før Pi-en starter, så om den ikke finner Pi-en med en gang, vent noen minutter og prøv igjen. Dere kan også trykke piltast opp på tastaturet for å bruke den siste kommandoen dere brukte.
* Dobbeltsjekk også at det delte nettet opererer på 2.4GHz. På iPhone gjøres dette ved å gå inn i "settings"->"personal hotspot", og skru på "maximise compatibility".
* Hvis dere har koblet dere av internettet og på et annet en eller annen gang i løpet av dagen så kan det hende programmet ikke gjenkjenner igjen ip-adressen. Ta å skriv på SD kortet igjen, men denne gangen endre brukernavnet til noe annet enn gruppenavnet. Brukernavnet kan dermed ikke være det samme som det noen andre har brukt før.

Når dere skriver inn passordet, vil dere merke at det ikke kommer opp noe "***". Dette er normalt, bare skriv passordet som vanlig.

Dere vil få opp noe liknende dette:
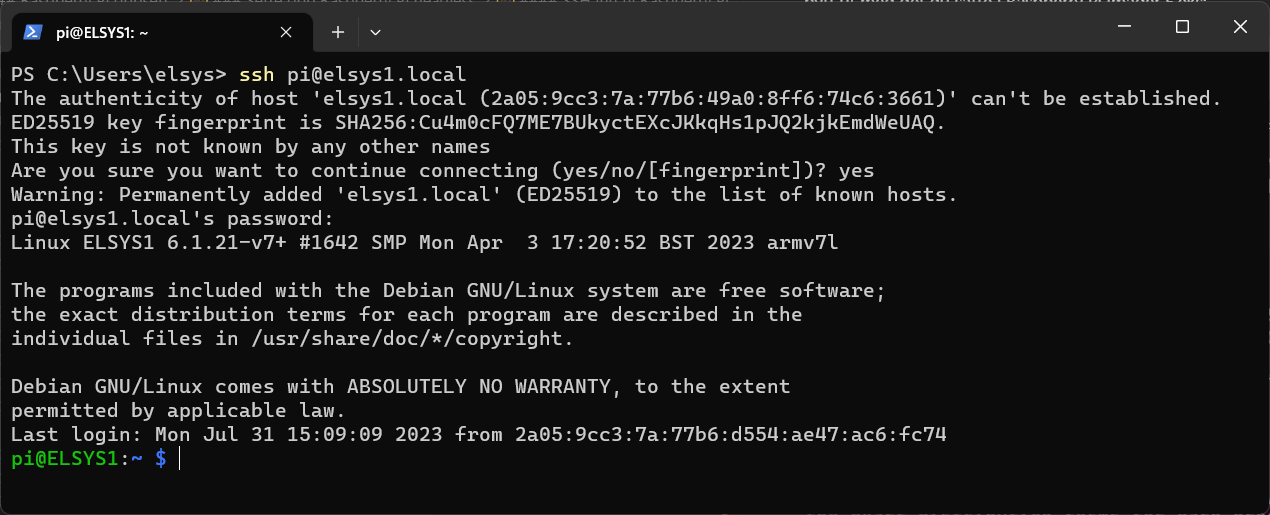
[picture p34: Media/rpi/03SSH.png]
SSH into Raspberry Pi


Gratulerer, dere har nå logget på Raspberry Pi via SSH. Kommandoene dere nå skriver utføres på terminalen inne på selve Raspberry Pi.

Tips til å skrive i terminalen:
- Grunnleggende terminalkommandoer for navigering:
  - **`cd <directory>`**: Bytter katalog. Denne kommandoen lar deg navigere mellom forskjellige mapper på datamaskinen din. For eksempel, `cd Documents` vil navigere til Documents-mappen fra din nåværende lokasjon.
  - **`ls`**: List opp innholdet i den nåværende mappen. Denne kommandoen viser alle filer og mapper i den nåværende mappen, hvor mapper vil dukke opp i blått.
  - **`cd ..`**: Gå opp ett nivå i mappestrukturen. Dette tar deg tilbake til mappen som inneholder den nåværende mappen.

#### Enable camera
Aktiver kameraet på RPI-en med kommandoen:

```bash
sudo raspi-config
```

Det vil dukke opp en liten meny. For å navigere trykker dere "Tab" for å skifte hvilket alternativ dere er på, og "Spacebar" for å velge det alternativet.

Naviger nå til "Interface options" og trykk "Space". Deretter naviger til "Enable legacy camera" og trykk "Space". Nå burde det ha kommet opp en prompt som spør noe med ordlyden "Do you want to enable legacy camera". Velg "Yes" for å enable.

Etter dette er gjort naviger tilbake igjen til første menyen dere startet på, og deretter til knappen som heter "Finish". Etter at dere har valgt finish burde det dukke opp en prompt som spør om dere har lyst til å reboote systemet. Velg "Yes".

Nå burde Pi-en starte å reboote, som betyr at dere vil miste tilgang til den. Etter ca. 1 minutt burde Pi-en være klar igjen, så det er bare å SSH inn igjen på Pi-en.

Start deretter PIen på nytt med kommandoen: 

#### Få inn riktig programvare
Viktig å bemerke at alle kommandoer dere kjører skjer i mappen dere kjører dem i. Så dere kan ikke kjøre et program (som "runCode.py) uten å være i samme mappe som programmet. Dette gjelder ikke kommandoer med apt eller pip, siden disse gjør endringer i hele systemet og ikke kun lokalt i nåværende mappe.

1. Dere kan nå oppdatere og oppgradere med kommandoene

```bash
sudo apt-get update && sudo apt-get dist-upgrade -y
```

2. Dere kan nå klone git-repositoriet som inneholder koden som Raspberry Pi-en skal kjøre, med kommandoen:

```bash
git clone https://github.com/NTNU-IES-education/teknobil.git
```

3. Deretter kan dere navigere til "Teknostart"-mappen med kommandoen:
   
```bash 
cd teknobil/
```
<p>
  

Merk at det i blått angir hvilken mappe dere befinner dere i. Prøv kommandoen 'cd ..' for å gå tilbake eller 'ls' for å vise hvilke andre filer eller mapper som er tilgjengelige.
</p>

4. Last ned den ekstra programvaren som kreves for å kjøre koden, med kommandoen:

```bash
pip3 install -r requirements.txt && sudo apt-get install libatlas-base-dev -y && sudo apt-get install python3-pyro4 -y
```

5. Når nedlastingen er fullført, kan dere navigere videre til "projectfolder" med kommandoen:

```bash
cd projectfolder/
```
6. Når Arduino-koden er ferdig lastet opp, kan dere kjøre Python-koden med kommandoen:

```python
python runCode.py
```

Ved å kjøre denne kodelinjen får dere opp en IP-adresse som dere kan gå til i nettleseren for å få videofeed og kjøre bilen. Når dere skal stoppe koden fra å kjøre, trykk "STOP" i nettleseren. For å teste objektgjenkjennelsen, trykk "COMPARE"

# Utvidelser

Når dere har fullført bilbyggingen, er det på tide å tilpasse bilen og legge til de utvidelsene dere ønsker. Utvidelsene er listet her i en rekkefølge vi mener går fra lavest til høyest nivå, men dere kan utføre dem i hvilken som helst rekkefølge. Dere kan også velge å hoppe over utvidelsene og begynne direkte med dekorasjonen. Hvis dere har andre ideer til utvidelser og trenger andre komponenter enn det som er tilgjengelig, ta kontakt med en studass. Platene kan kuttes, bores og modifiseres etter ønske, men husk at elektronikken inni skal gjenbrukes til neste år.

## Hastighet

Det er mulig å endre bilens hastighet både i Arduino-koden og ved å endre motorspenningen. Økt hastighet kan være en stor fordel hvis dere ønsker å vinne raskeste bil. Men sørg for å teste underveis slik at dere fortsatt har kontroll.

### Kode

Bilens hastighet er definert i Arduino-koden i linjene nedenfor.

```c
//SPEEDS
int drivingSpeed = 150;
int turningSpeed = 50;
```

Bla ned til dere finner dette i koden din, og lek med tallverdiene. Med hvilke verdier er bilen raskest?
### Omkobling av motorspenning

En annen måte å øke bilens hastighet på er ved å øke spenningen til motorene. Slik bilen er koblet opp nå, er motordriveren koblet til 5 V fra regulatoren, det samme som Arduino og Raspberry Pi. Men dere kan enkelt koble om spenningen til motordriveren slik at den er koblet direkte på batterispenningen. Bruk dokumentasjonen for spenningsregulatoren som dere finner [her](https://wiki.dfrobot.com/Power_Module__SKU_DFR0205_) til å gjøre dette.

## Tutehorn

Det er gøy å tute. Det synes alle. Dere kan få en buzzer utdelt fra en studass. Koden for at dette skal fungere på bilen deres er allerede skrevet, men den er kommentert ut i filen runCode.py. Dere må lese gjennom koden for å finne ut hvordan tutehornet fungerer. Målet med denne oppgaven er ikke at dere skal forstå all koden, men få erfaring med å endre filene dere har på Pi-en. Programmet runCode er skrevet i programmeringsspråket Python som dere vil lære etter hvert.

1. Koble opp buzzeren med siden som er merket med + til GPIO 21 på Raspberry Pi og den andre siden koblet til GND.
2. Nå må dere endre programmet runCode.py. Nano er en teksteditor som dere kan kjøre fra terminalen. Åpne runCode i nano.
   
```bash
nano runCode.py
```

I Nano kan dere navigere med piltastene og bla ned gjennom koden. I Python kan dere kommentere ut ved å plassere # foran teksten dere ønsker å kommentere. Da kommenterer dere ut den ene linjen dere skriver på. Skal dere kommentere ut flere linjer bruker dere """ <teksten her ignoreres av Python> """.

Første kodesnutt som er kommentert bort er vist under. Fjern """ begge steder slik at koden ikke er kommentert bort.

```p
# ------------------------
"""
# Buzzer setup
BUZZER = 12
GPIO.setup(BUZZER, GPIO.OUT)
buzzer = GPIO.PWM(BUZZER, 1000) # Set frequency to 1 kHz
"""
# ------------------------
```

Det er tre slike kommentarer som må fjernes. Dere må nå finne de to andre og gjøre det samme med dem. De er markert på samme måte som koden over.

3. Når dere har fjernet alle tre kommentarene, lukk Nano ved å trykke Ctrl+X, deretter Y for å lagre og så Enter. Nå kan dere kjøre koden på nytt og kjøre rundt som før. Når dere trykker Space, skal buzzeren spille av en vakker lyd.
4. Nå kan dere prøve å sette en annen frekvens eller duty cycle for buzzeren.

   LOBE 
2022 - 2026
Takk for alt

## Kuleste bil??
Dere vil nå være nesten klare for å konkurrere og teste bilene deres ut i banen. Alt som mangler nå er litt ✨dekorasjon✨. Dere skal bruke det dere kan finne av papp, maling eller kanskje til og med elektroniske komponenter for å gjøre bilene helt deres. Følg et tema eller bare bruk kreativiteten. Det er 4 konkurranser dere kan vinne:

1) Raskeste bil
2) Smarteste bil
3) Fan favorite
4) Kuleste ekstrafunksjon

Om dere har tid og vil utforske litt så kan dere se inn i elsys kofferten. Der skal det ligge alle mulige komponenter slik som servo motorer, ekstra led lys, høytaler ol. Spør en studentass eller søk på nett for hvordan man kobler de opp, kanskje dere får den kuleste bilen?

Det er en mulighet å endre ting i selve Raspberry Pi koden, men det er ikke anbefalt. Fra tidligere erfaring slutter ting å fungere og studentassistentene kan ikke nødvendigvis løse det. Hvis dere likevel ønsker å gjøre det, vær forberedt på å måtte gå tilbake til den originale koden!
