NTNU-IES-education/teknobil/Media/Lobe/deletelobe.png

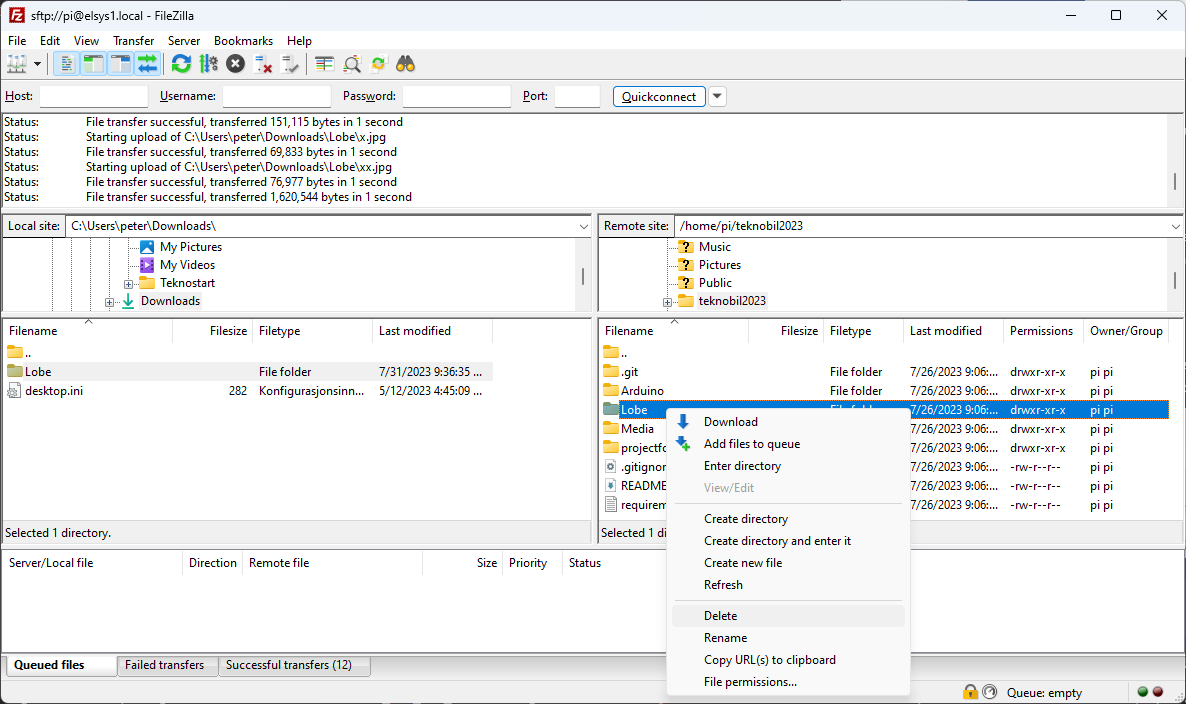
Media/Lobe/deletelobe.png
