NTNU-IES-education/teknobil/Media/Lobe/export.png

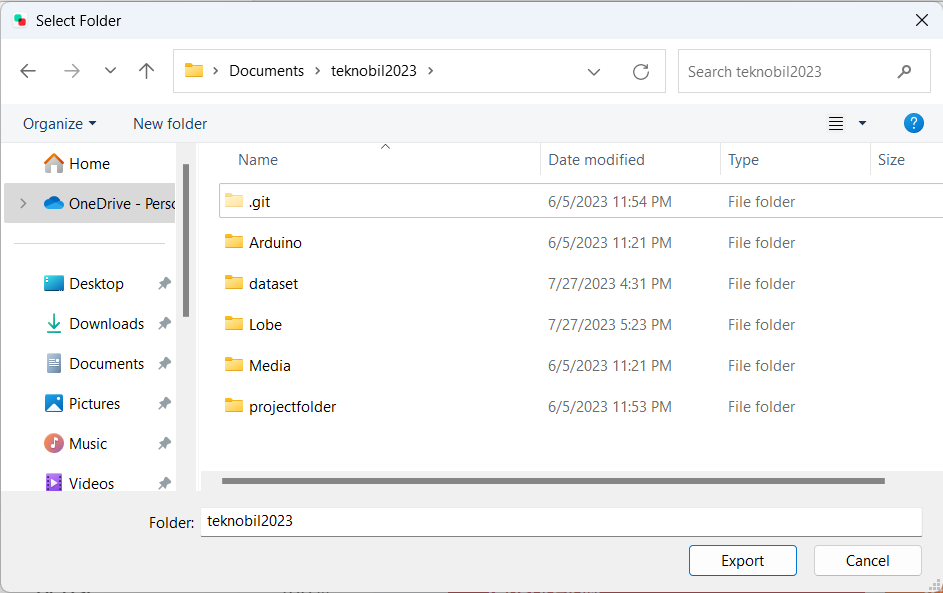
Media/Lobe/export.png
