NTNU-IES-education/teknobil/Media/Lobe/import.png

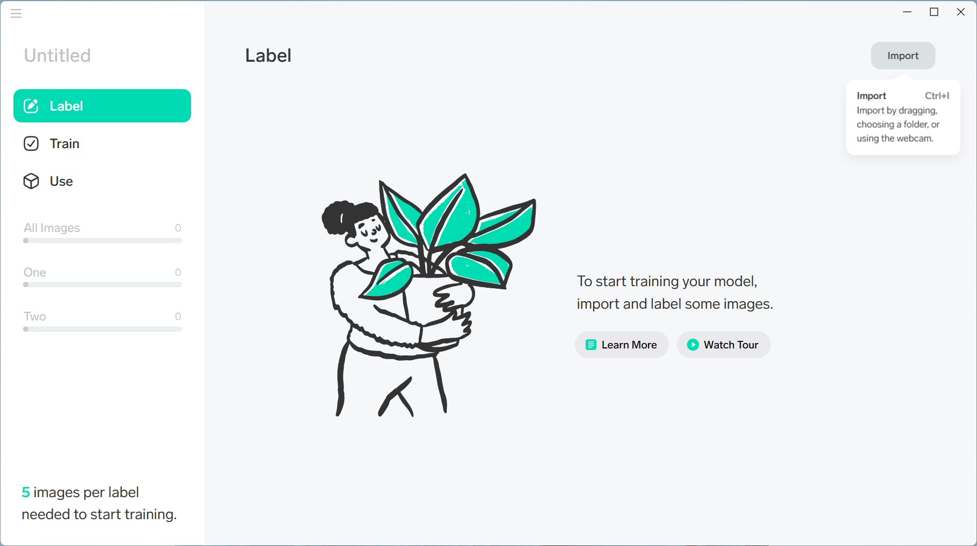
Media/Lobe/import.png
