NTNU-IES-education/teknobil/Media/Lobe/importDataset.png

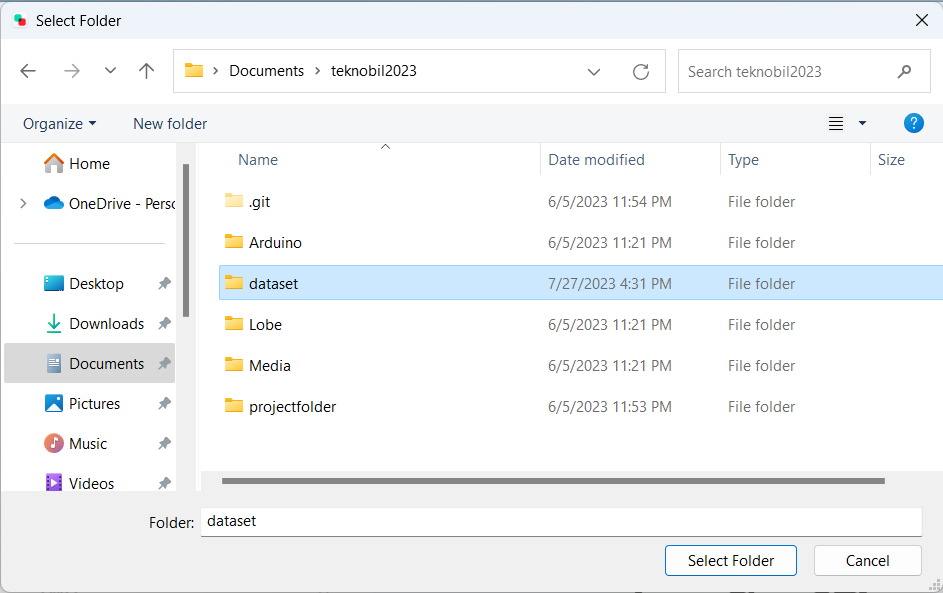
Media/Lobe/importDataset.png
