NTNU-IES-education/teknobil/Media/Lobe/keepTraining.png

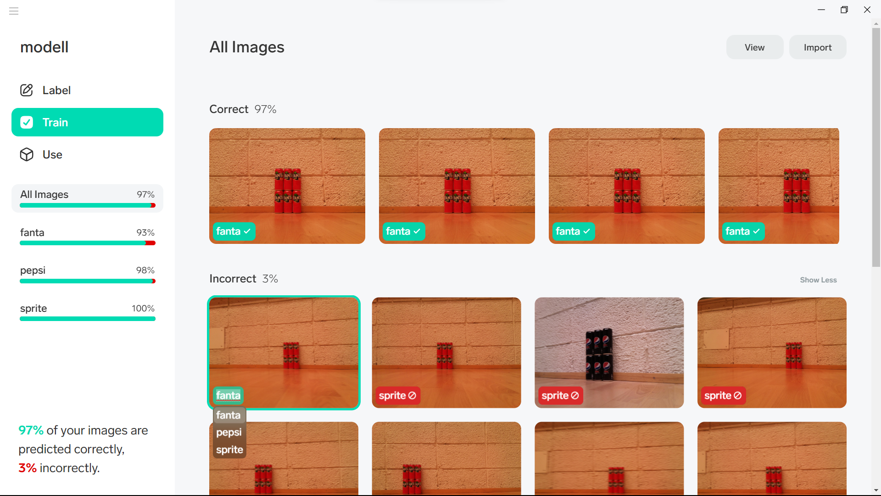
Media/Lobe/keepTraining.png
