NTNU-IES-education/teknobil/Media/Lobe/lable.png

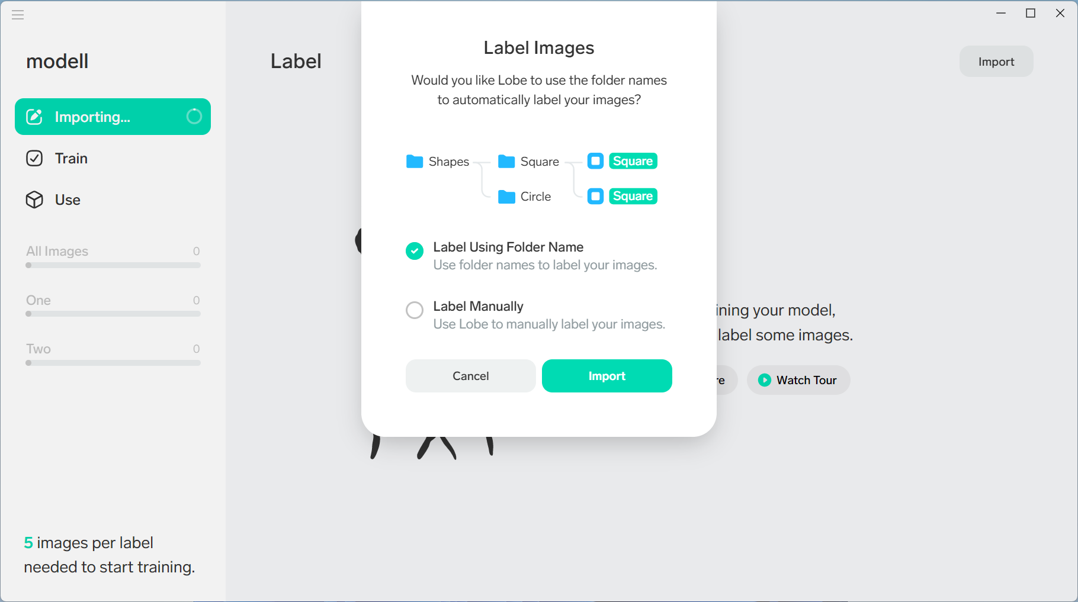
Media/Lobe/lable.png
