NTNU-IES-education/teknobil/Media/Lobe/navtekno.png

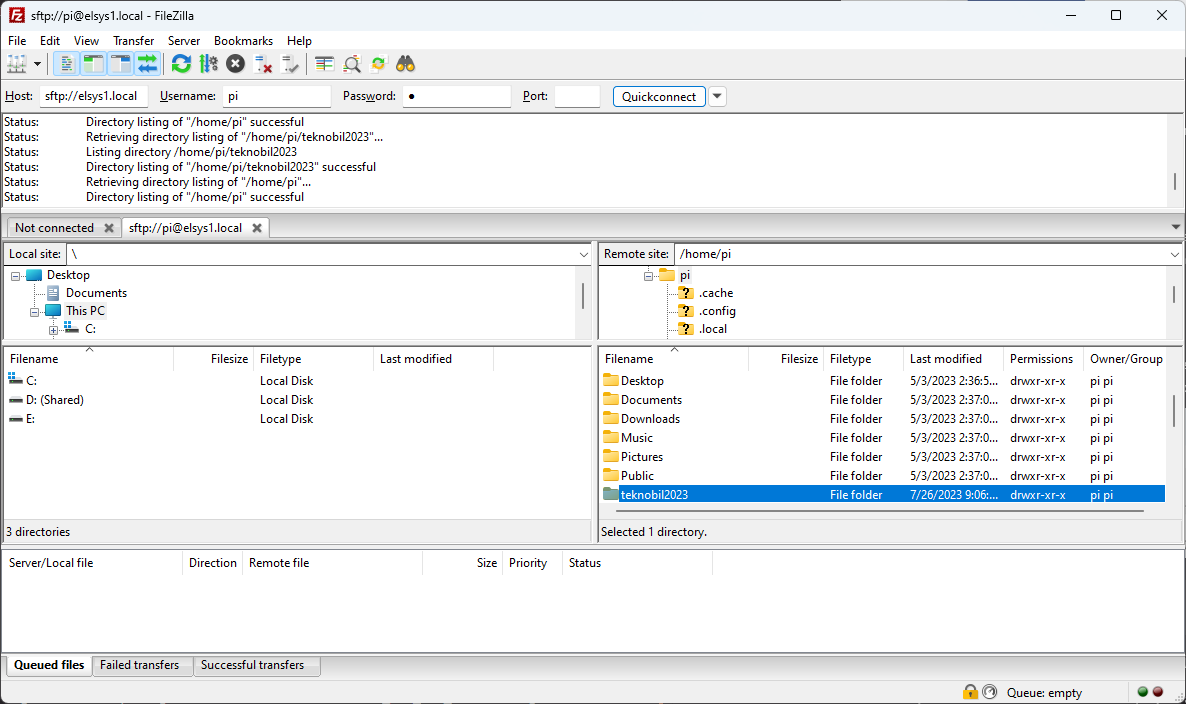
Media/Lobe/navtekno.png
