NTNU-IES-education/teknobil/Media/Lobe/newProject.png

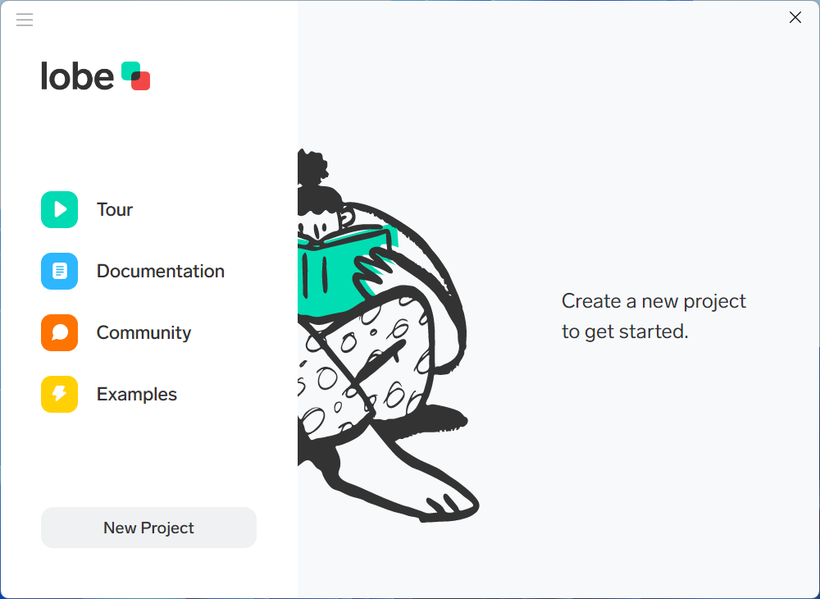
Media/Lobe/newProject.png
