NTNU-IES-education/teknobil/Media/Lobe/optimize.png

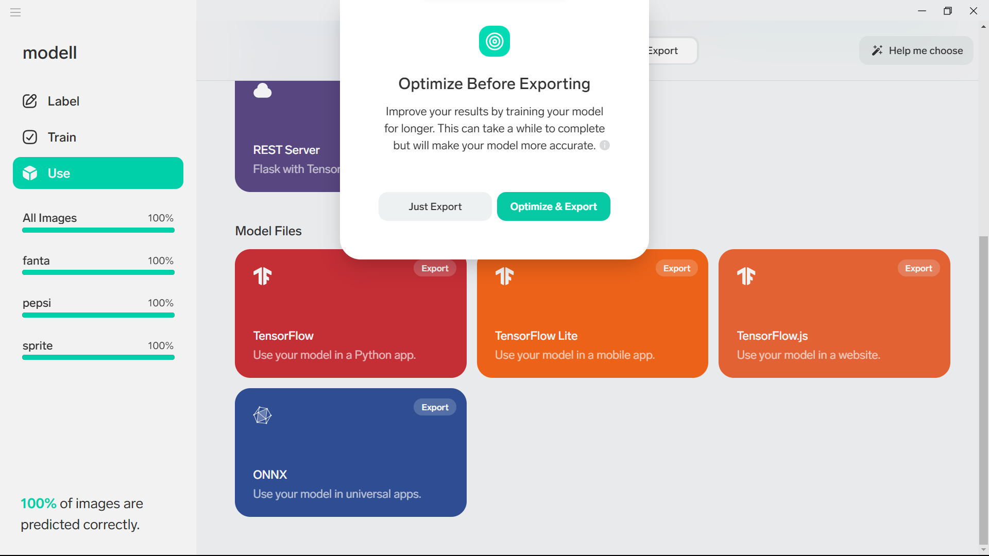
Media/Lobe/optimize.png
