NTNU-IES-education/teknobil/Media/Lobe/startnow.png

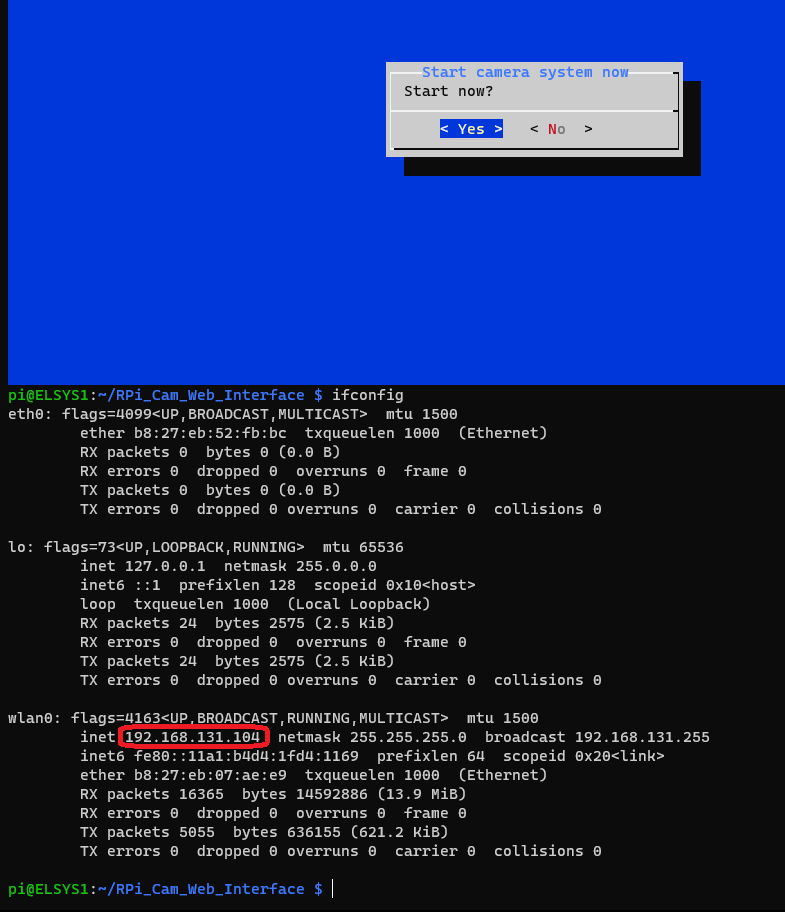
Media/Lobe/startnow.png
