NTNU-IES-education/teknobil/Media/Lobe/tensorFlowLite.png

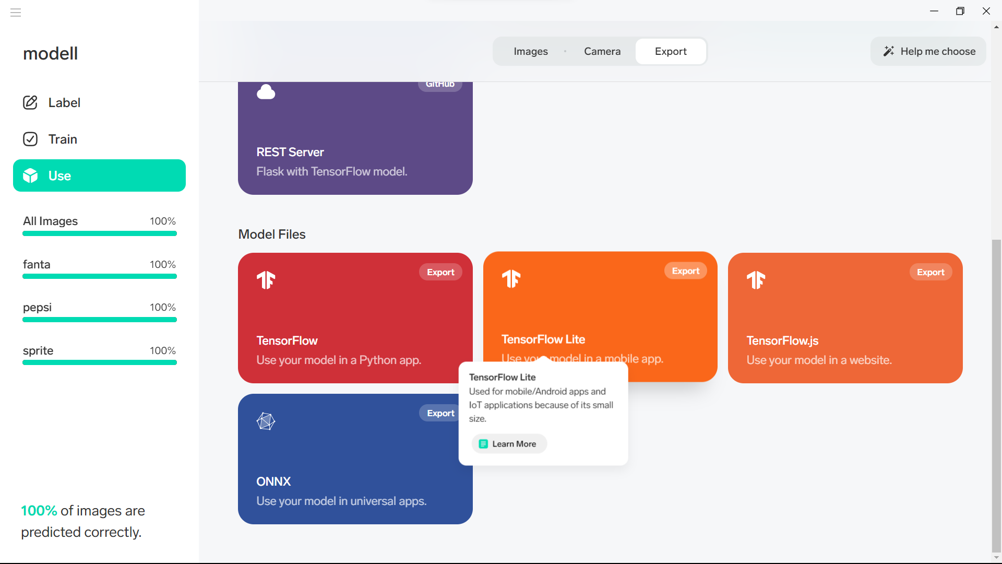
Media/Lobe/tensorFlowLite.png
