NTNU-IES-education/teknobil/Media/Lobe/train.png

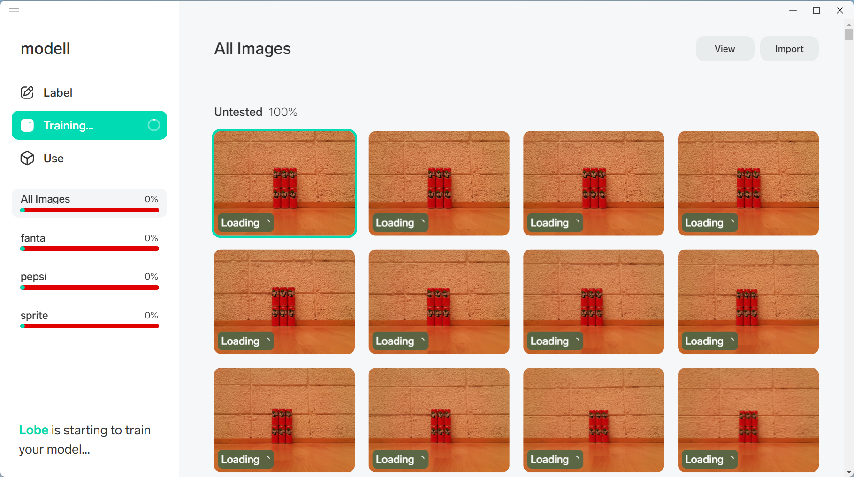
Media/Lobe/train.png
