NTNU-IES-education/teknobil/Media/rpi/00Pi-imager-download.png

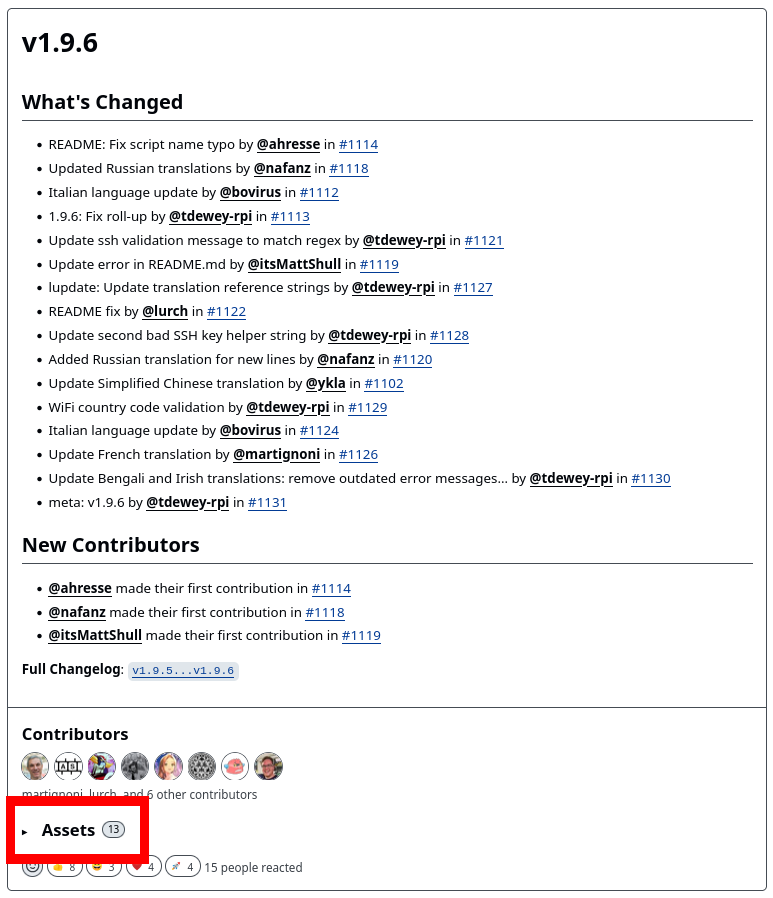
Media/rpi/00Pi-imager-download.png
