NTNU-IES-education/teknobil/Media/rpi/01-Pi-imager-ny.png

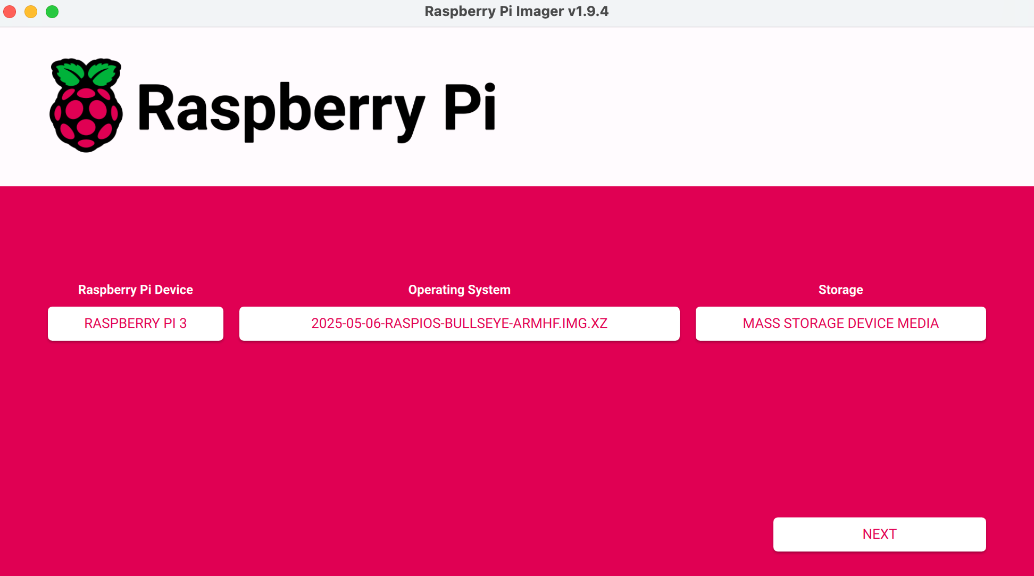
Media/rpi/01-Pi-imager-ny.png
