NTNU-IES-education/teknobil/Media/rpi/02settings.png

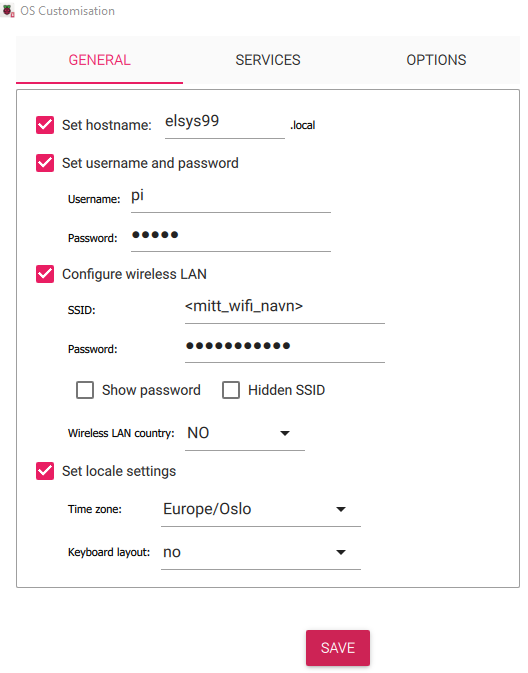
Media/rpi/02settings.png
