NTNU-IES-education/teknobil/Media/rpi/02settingssh.png

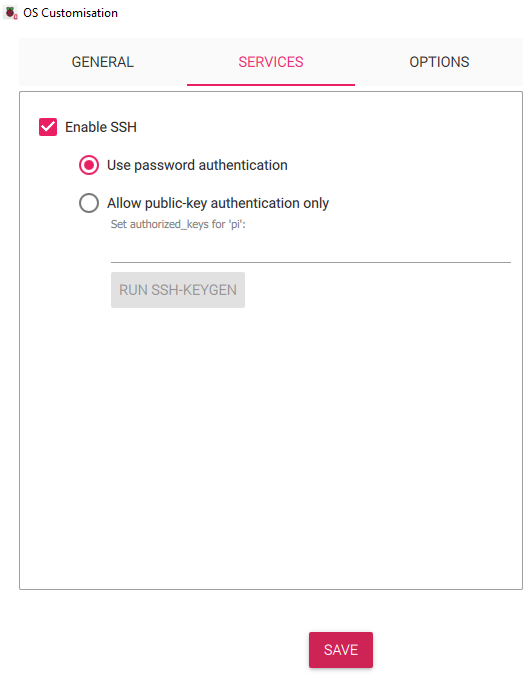
Media/rpi/02settingssh.png
