NTNU-IES-education/teknobil/Media/teknobil/05.png

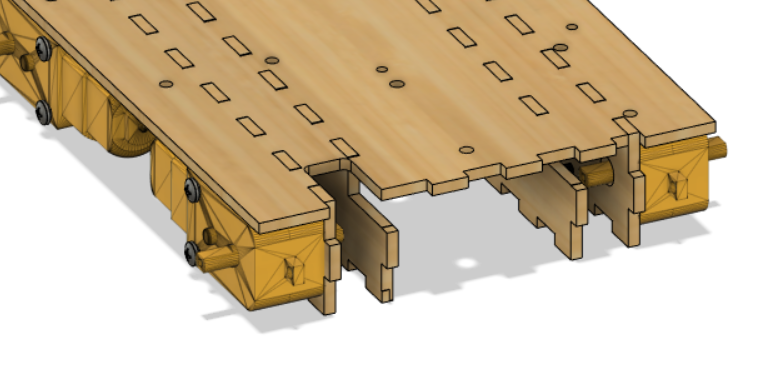
Media/teknobil/05.png
