NTNU-IES-education/teknobil/Media/teknobil/07.png

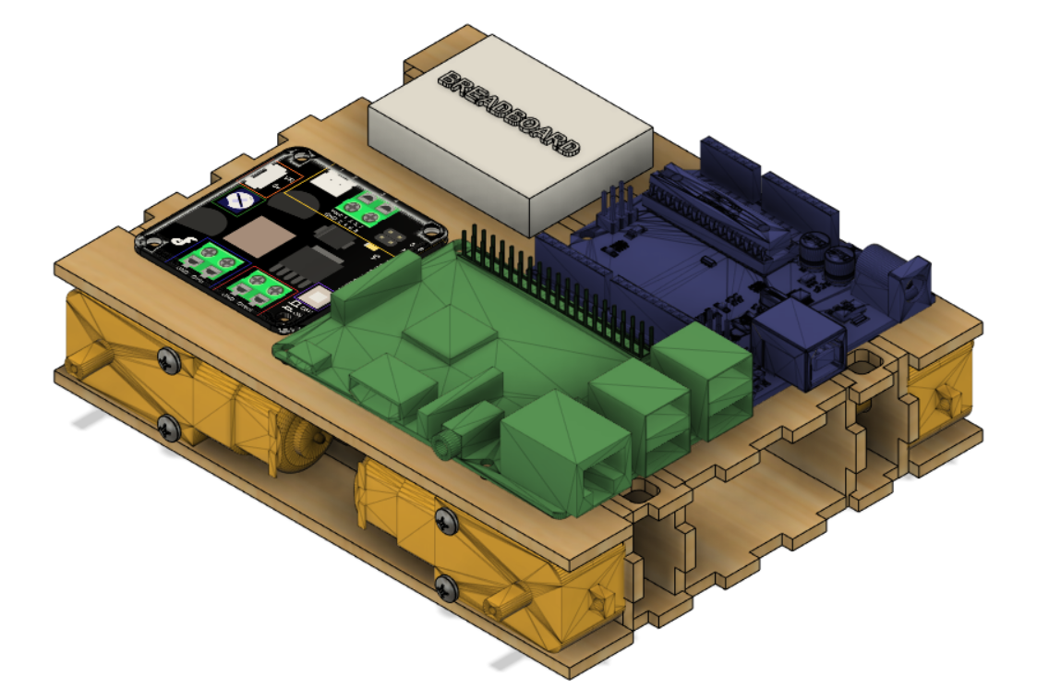
Media/teknobil/07.png
