NTNU-IES-education/teknobil/Media/teknobil/12.png

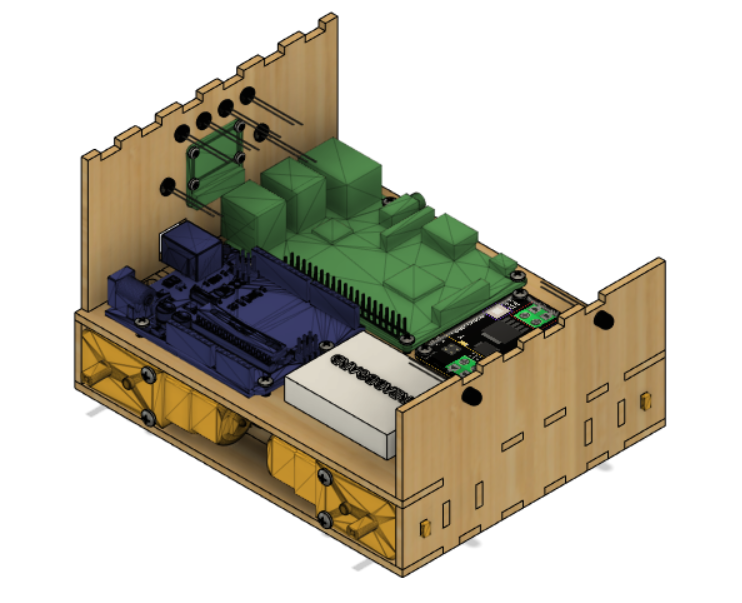
Media/teknobil/12.png
