NTNU-IES-education/teknobil/Media/teknobil/13.png

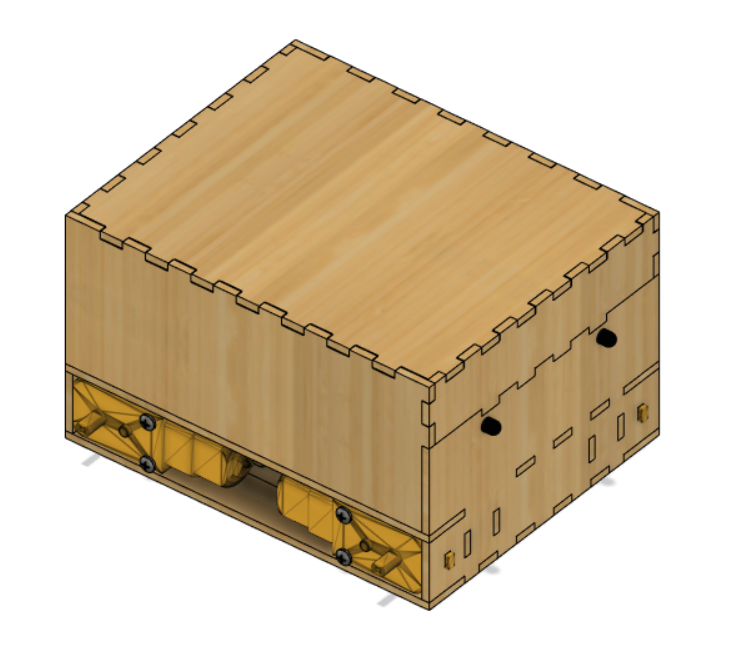
Media/teknobil/13.png
