NTNU-IES-education/teknobil/Media/teknobil/LEDSchematic.jpeg

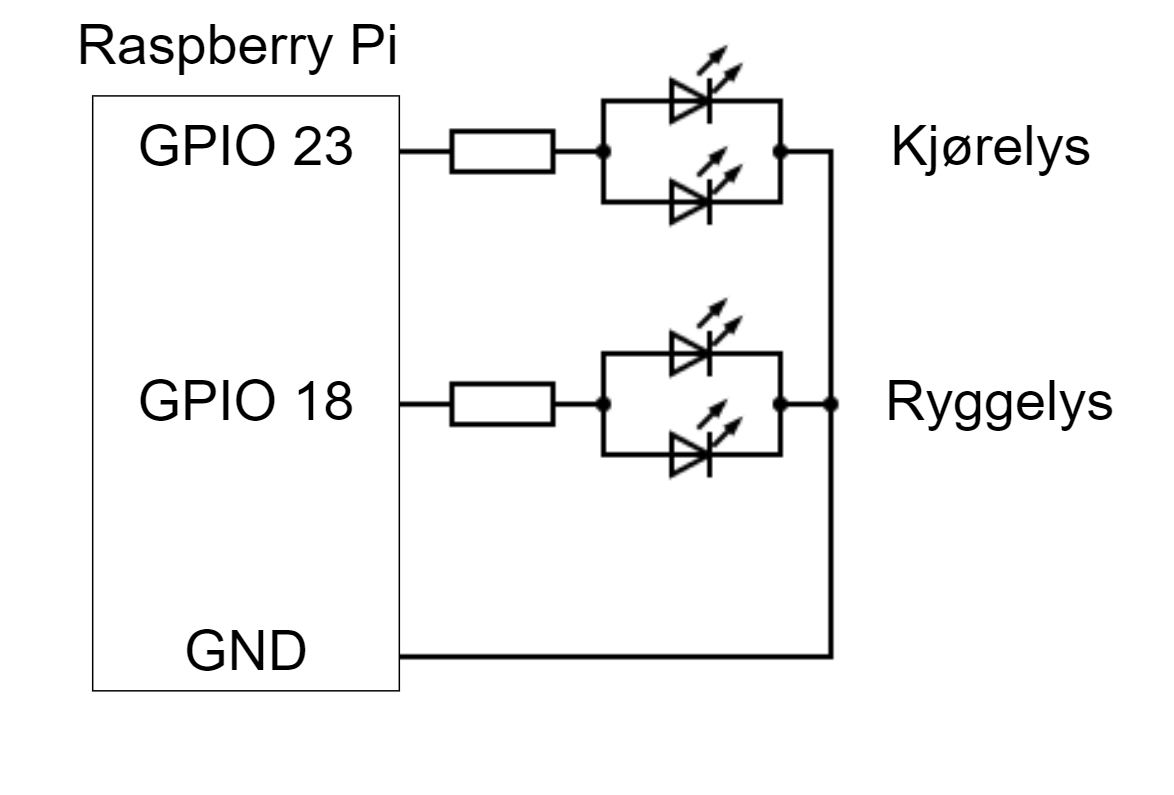
Media/teknobil/LEDSchematic.jpeg
