NTNU-IES-education/teknobil/Media/teknobil/ledsymbol.png

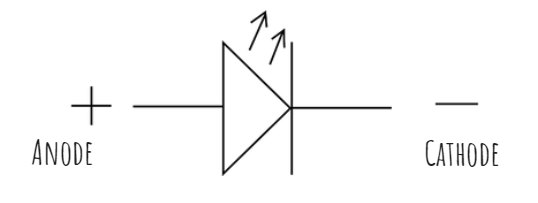
Media/teknobil/ledsymbol.png
