NTNU-IES-education/teknobil/Media/teknobil/MotorDriverPinout.png

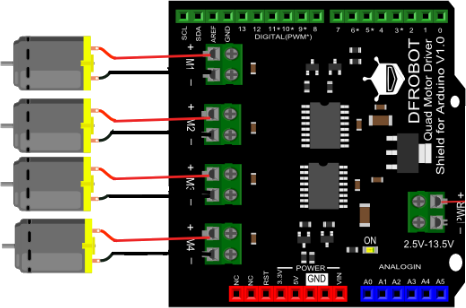
Media/teknobil/MotorDriverPinout.png
