NTNU-IES-education/teknobil/Media/teknobil/motstandsymbol.png

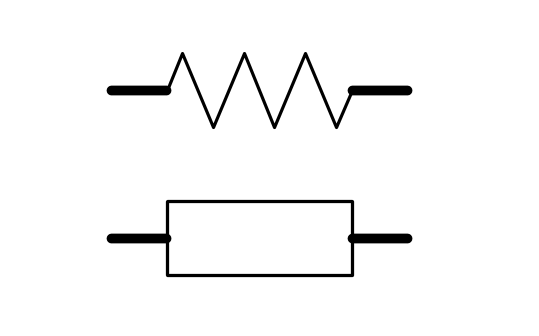
Media/teknobil/motstandsymbol.png
