NTNU-IES-education/teknobil/(commit log)

2023-08-07 arduino code readme
2023-08-07 fixed digital read issue
    [Arduino.ino]
2023-08-16 Update runCode.py
    Added commented buzzer functionality in multithreading on GPIO 12.
    [runCode.py]
2024-07-02 Nytt arduinobilde
2024-08-10 Update README.md
    Oppdatering av instruksjoner for Raspberry pi for å koble til nettverksruter. Har beholdt delt internett for android telefon som alternativ fremgangsmåte dersom nettverksruteren ikke virker.
2024-08-12 Update README.md
    endret på skrivefeil, la til en mulig løsning og skev om dekorasjon og ekstra funksjoner til bilen på slutten
